inventowiz/Hail-Met/docs/poster/alberta-saferoads-helment-poster.jpg

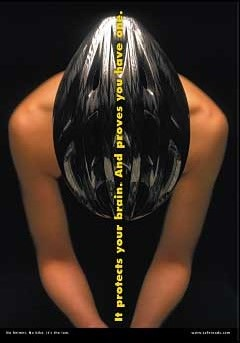
docs/poster/alberta-saferoads-helment-poster.jpg
