inventowiz/Hail-Met/docs/poster/DSC_0001.JPG

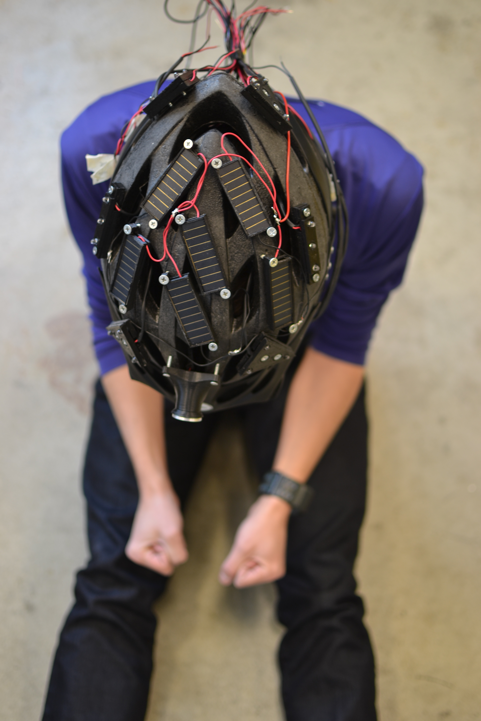
docs/poster/DSC_0001.JPG
