inventowiz/Hail-Met/README.md

Hail-Met
========

A repo for work done on the Hail-met project for EECS 473, Fall 2014.
