inventowiz/Hail-Met/docs/poster/poster final USE THIS ONE.pdf

### EECS 473 Advanced Embedded Systems: Fall 2014

Brian Daniels, Patrick Hayes, Alex Jaeckel, Brian Margosian, and Ben Wang {bridadan, pathayes, ajaeckel, bmargosi, benwang} @umich.edu https://github.com/inventowiz/Hail-Met
© 2013 Regents of The University of Michigan

# An all-in-one multi-purpose helmet

for the modern commuter.

# Hail-Met!

# Intro

# Problem

# Solution

# Interfacing & Software Design

# Prototyping, Testing, & Issues

# Hardware

Custom PCB

PCB with Bluetooth, LiPo Battery, Charging, and LED Driver
Turn Signals, Headlight and Taillight

Speakers

Solar panels

Heads up display (HUD)

The Hail-met runs on an
ATMega328 processor that
we developed on using the
Arduino IDE. We developed
our own libraries for each component so that we could more easily write software to interface with them. The software is responsible for monitoring each button and sensor input, and activating each respective component in response.

Besides protecting your head from direct contact with hard surfaces, traditional bike helmets don’t offer many benefits to consumers. Advanced communication, entertainment, and night-time safety features come standard with every new car, but don’t yet exist for cyclists.

Advanced communication,
entertainment, and night-time safety features come standard with every new car, but don’t yet exist for cyclists.

More modular solutions (like stand-alone detachable bike head lights) do exist but are easily stolen if they are not detached when the bike is in public.

Bicycle helmets are exposed to the elements (moisture, dust, etc.), so embedding electronic devices into a helmet is no easy feat.

Our group designed a smart bike helmet. It extends the functionality of traditional bike helmets by adding safety and productivity features like headlights and taillights, turn signals and Bluetooth communication.

Users will be able to stream music to their helmet while they commute as well as answer incoming phone calls, all over Bluetooth. Rider visibility will be increased due to the remarkably bright LED headlight and the LED turn signals. To top it all off, the helmet will be completely powered by solar panels and a small battery. The user can charge the helmet’s battery through any standard USB port, and the solar panels will also charge the battery during your ride!

Circuit Progress

Initial circuit on a breadboard | First view of the unpopulated PCBs

Populated, tested, and running PCB

Milled and cleaned 3-D printed part

First mockup of the Hail-met layout Continuing to add parts to the final prototype

Helmet Process

Microcontroller
(ATmega328)

Photovoltaic
Cells

Charging
circuit | Bluetooth
| module
| (RN-52)

Audio
Amplifier
(LM4880)

Headset
Microphone

LED Driver
(TLC5917IN)

Left turn signals -
front

Left turn signals -
middle

Right turn
signals - front

Right turn
signals - middle

Right turn
signals - rear

Left turn signals -
rear

Rear headlight /
Brake light

Primary
Power Switch

Turn signal
sensors (x2)

User input
buttons (x3)

Front headlight

UART | Analog `

Low-batt
(digital)

3.3V Voltage
Regulator

Li-ion
batteries

Digital

Headset
Speaker
(Left)

Headset
Speaker
(Right)

Digital (x3)

Digital (x2)

Analog input

LED Driver
(TLC5917IN)

SPI (2x Digital)

Turn indicator
LED (left)

Turn indicator
LED (right)

Low-battery
indicator LED

SPI (2x Digital)

Digital

Analog

Digital (x2)

Analog
