inventowiz/Hail-Met/schematics/thermistor_resistor_calculator.xlsx

Sheet: Thermistor Resistors
Thermistor Resistance Calculator
This spreadsheet calculates the resistance of a thermistor given parameters fom the specificaion.
Developed by Ben Wang, 11/20/14, University of Michigan
Datasheet: | http://www.vishay.com/docs/29049/ntcle100.pdf
 | R_25C | R_cold | R_hot
Temperature (°C): | 25 | 0 | 41
Temperature (°C): | 297.15 | 272.15 | 313.15
Resistance (Ω): | 10449.13 | 34260.06 | 5329.97
Parameter: | Number | B_25/85 (K) | A | B(K) | C(K^2) | D(K^3) | R_25C
Value: | 9 | 3977 | -14.6337 | 4791.842 | -115334 | -3730535 | 10000
 | A | B | C
Quadratic coefficients: | 9930.09 | -752210714.6 | -3.469499398e+12
 | Solution 1 | Solution 2
R_T2: | 80111.9421 | -4361.30378 |  | <-- Final Values
R_T1: | 2.516980831 | 28997.48302
 |  |  | Solution 1 | Solution 2
Check: | 24000 | = | 24000 | 24000
 | 5000 | = | 5000 | 5000

Sheet: PROG1 - Charge Current
PROG1 - Charging Current
I_reg = 1000V / R_PROG1
where | R_PROG | kOhms
 | I_reg | mA
Battery Capacity: | 2500 | mAh
Charging C-rate: | 0.2 | C
Desired I_reg: | 500 | mA
R_PROG: | 2 | kOhms

Sheet: PROG3 - Charge termination
PROG3 - Charging Current selection resistor
I_termination = 1000V / R_PROG3
where | R_PROG | kOhms
 | I_REG | mA
Battery Capacity: | 2500 | mAh
Cutoff rate: | 0.05 | C
Desired I_term: | 125 | mA
R_PROG3: | 8 | kOhms

Sheet: VPCC
VPCC - Voltage Proportional Charge Control - Voltage divider
R1 | 270 | kOhm | (Top)
R2 | 100 | kOhm | (Bottom)
V_in | 4.551
R_eq | 0.2702702703 | kOhm
VPCC | 1.23 | V
