inventowiz/Hail-Met/docs/poster/DSC_0002.JPG

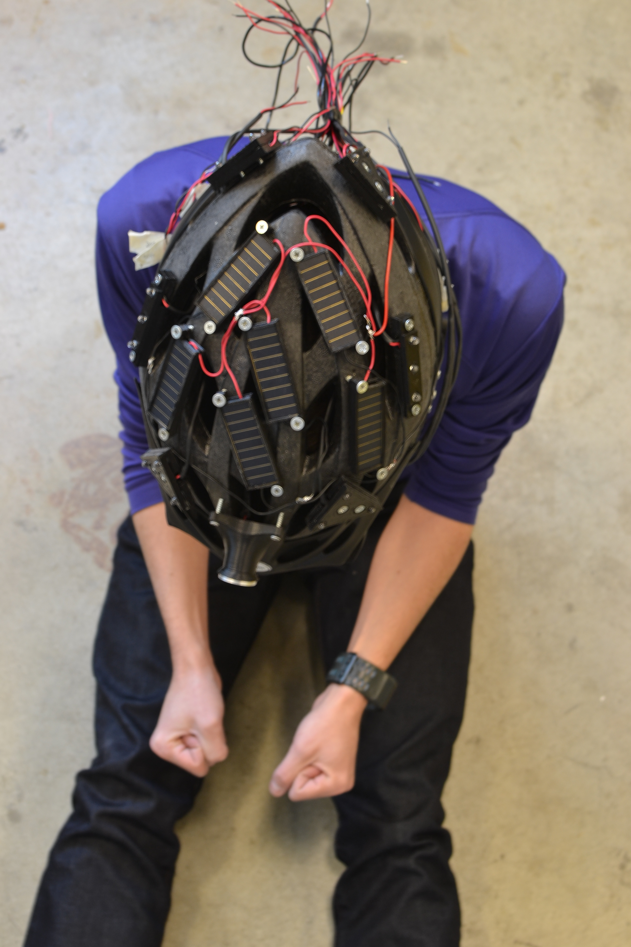
docs/poster/DSC_0002.JPG
