inventowiz/Hail-Met/docs/poster/DSC_0003.JPG

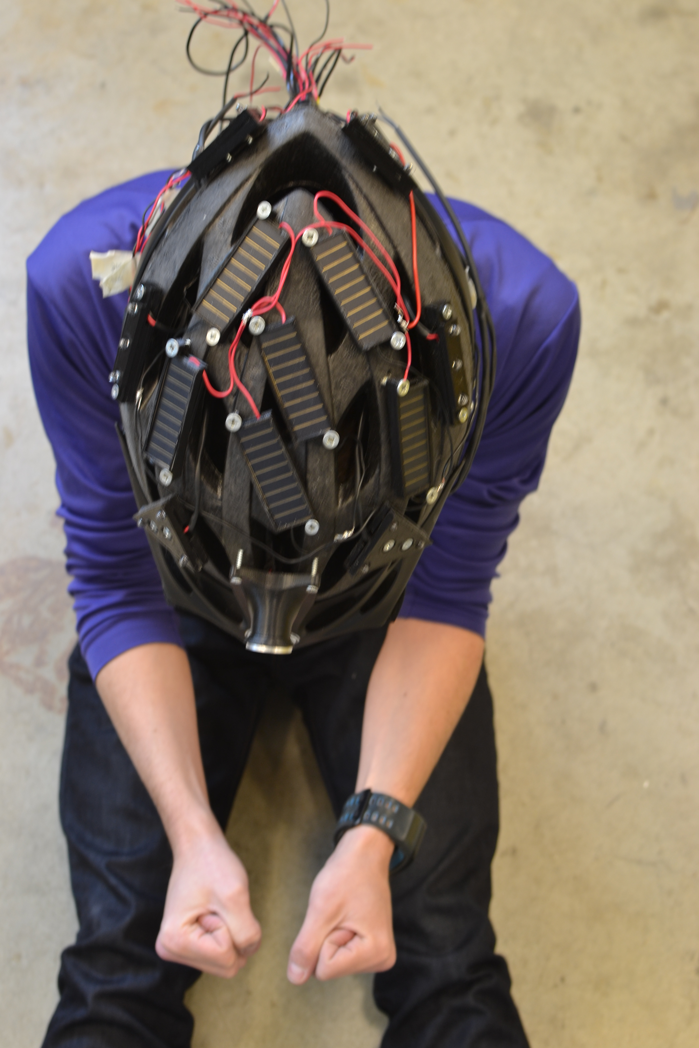
docs/poster/DSC_0003.JPG
