inventowiz/Hail-Met/docs/poster/helmet prototype 2.jpg

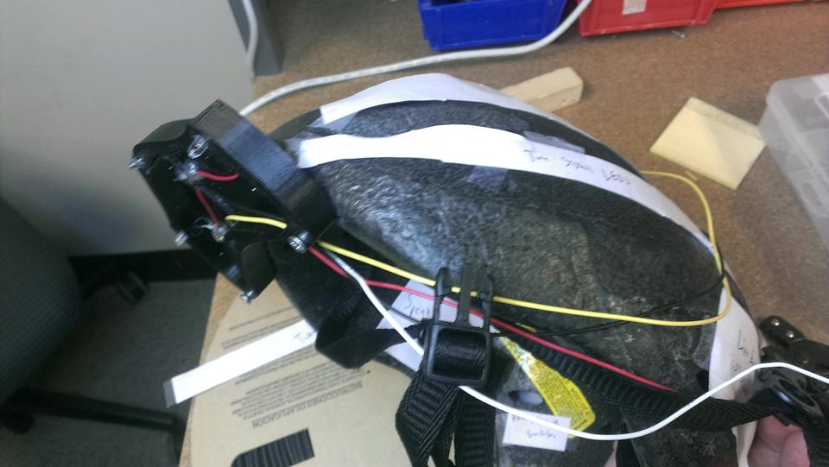
docs/poster/helmet prototype 2.jpg
