inventowiz/Hail-Met/docs/poster/helmet prototype.jpg

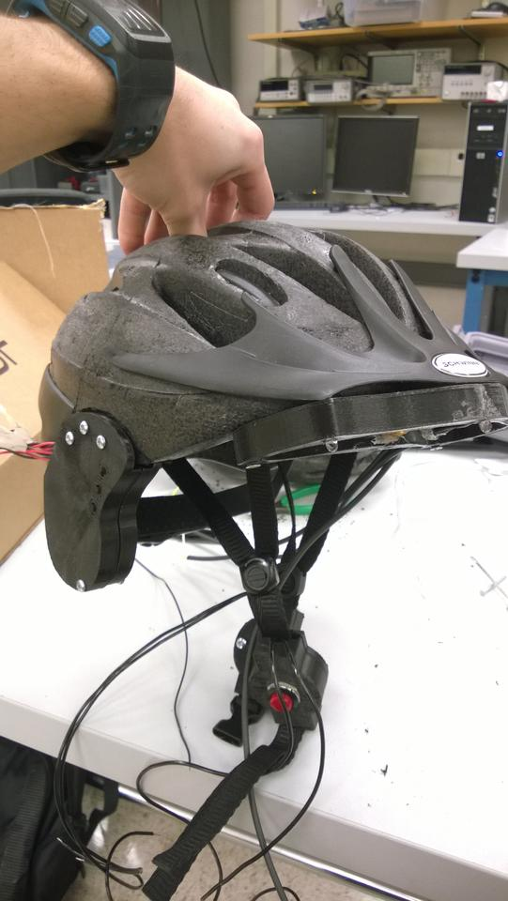
docs/poster/helmet prototype.jpg
