inventowiz/Hail-Met/docs/poster/Mill example.jpg

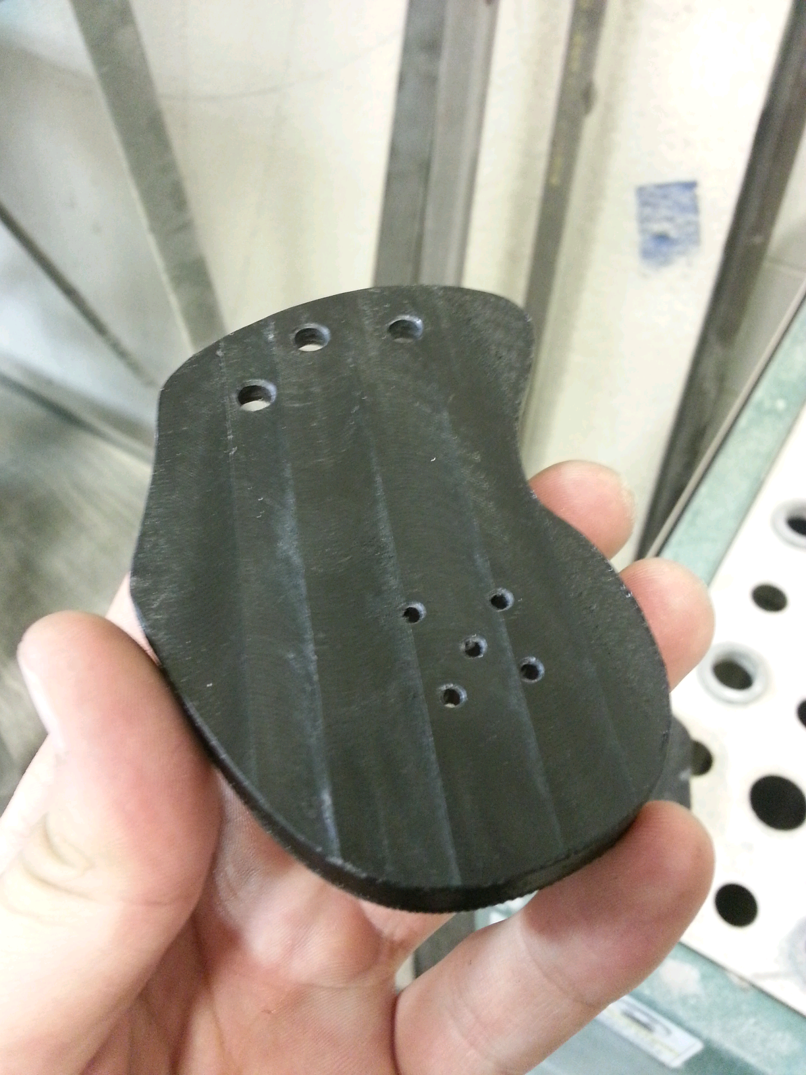
docs/poster/Mill example.jpg
