inventowiz/Hail-Met/schematics/BlockM-rball.bmp

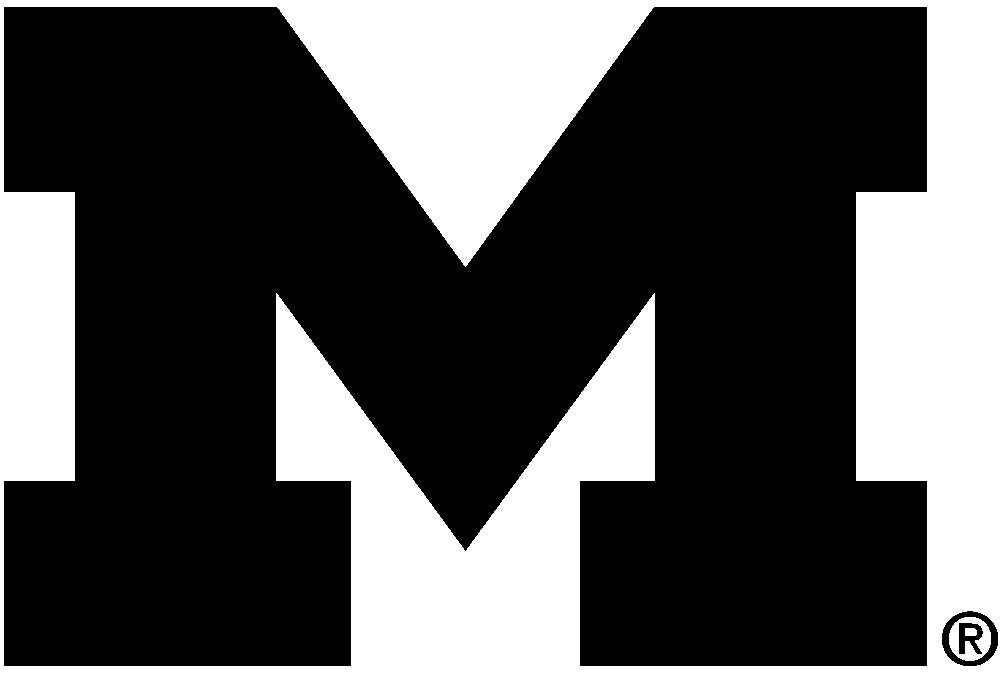
schematics/BlockM-rball.bmp
