inventowiz/Hail-Met/3dModels/chinModules/chinStrapModulev2.stl

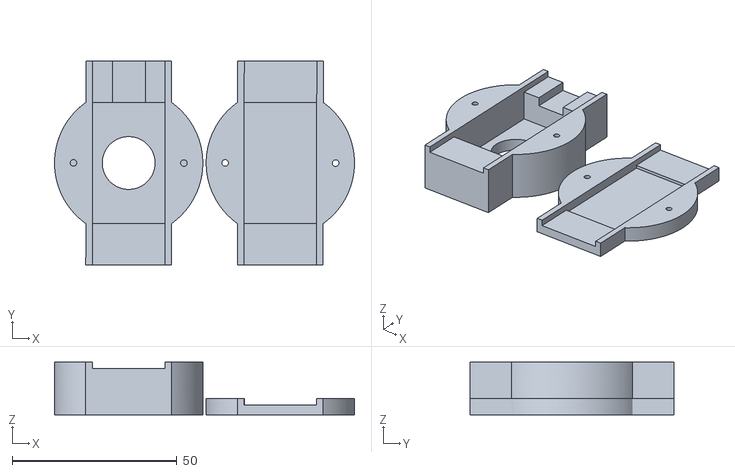
[picture p9: CAD file, 2014-11-24]
3dModels/chinModules/chinStrapModulev2.stl
91.0 x 62.0 x 16.0
