inventowiz/Hail-Met/3dModels/headlamp/headlamp_enclosure_cubify.stl

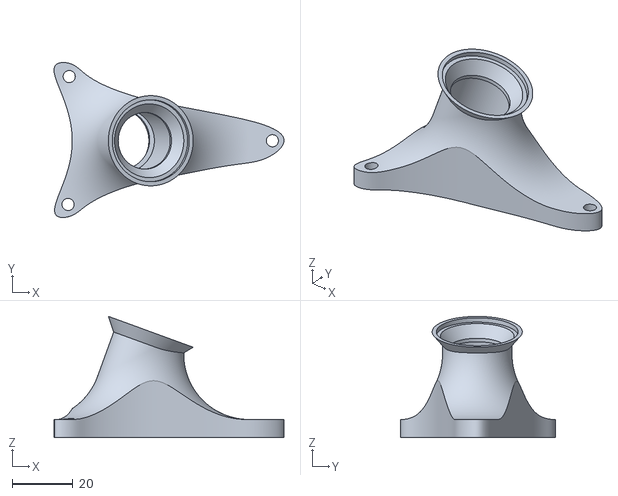
[picture p11: CAD file, 2014-10-27]
3dModels/headlamp/headlamp_enclosure_cubify.stl
75.9 x 51.1 x 40.0
