inventowiz/Hail-Met/3dModels/helmetBrim/helmetBrimRight.stl

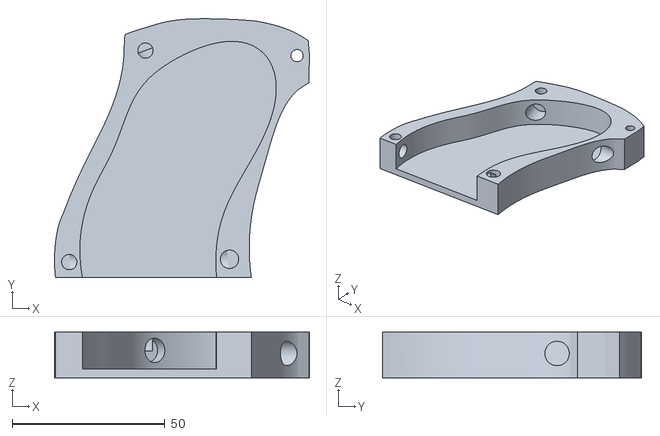
[picture p12: CAD file, 2014-11-17]
3dModels/helmetBrim/helmetBrimRight.stl
83.4 x 84.5 x 15.0
