inventowiz/Hail-Met/3dModels/lightSensorEnclosure/lightSensorEnclosure_cubify.stl

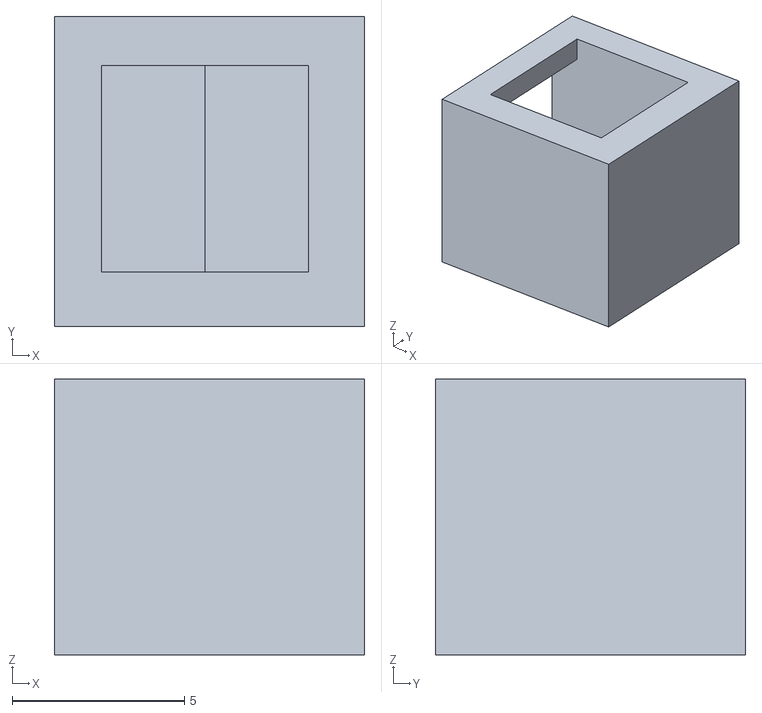
[picture p13: CAD file, 2014-12-03]
3dModels/lightSensorEnclosure/lightSensorEnclosure_cubify.stl
9.00 x 9.00 x 8.00
