inventowiz/Hail-Met/3dModels/pcbEnclosure/pcbEnclosureBatterySlot_cubify.stl

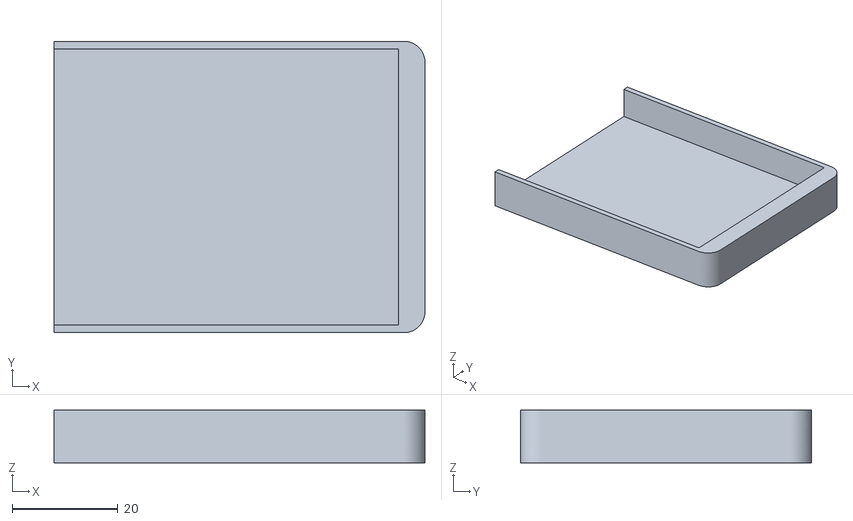
[picture p14: CAD file, 2014-12-03]
3dModels/pcbEnclosure/pcbEnclosureBatterySlot_cubify.stl
70.0 x 55.0 x 10.0
