inventowiz/Hail-Met/3dModels/powerSwitch/powerSwitch.stl

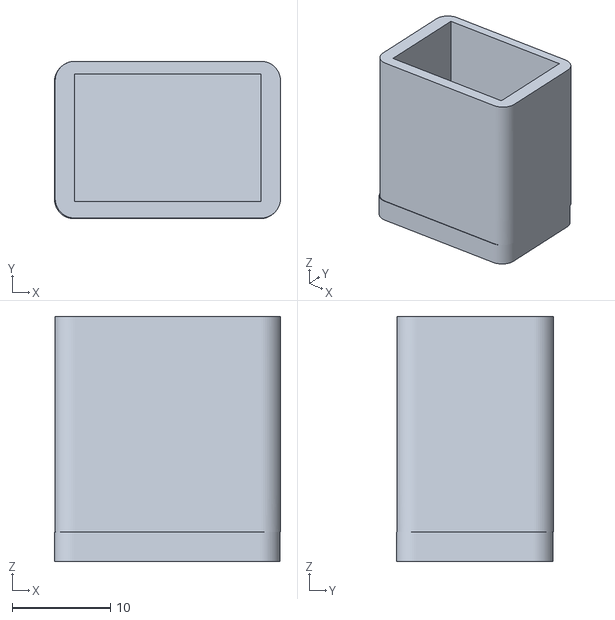
[picture p15: CAD file, 2014-12-03]
3dModels/powerSwitch/powerSwitch.stl
23.1 x 16.1 x 25.0
