inventowiz/Hail-Met/3dModels/solarPanelHousings/solarHousingGroup_cubify.stl

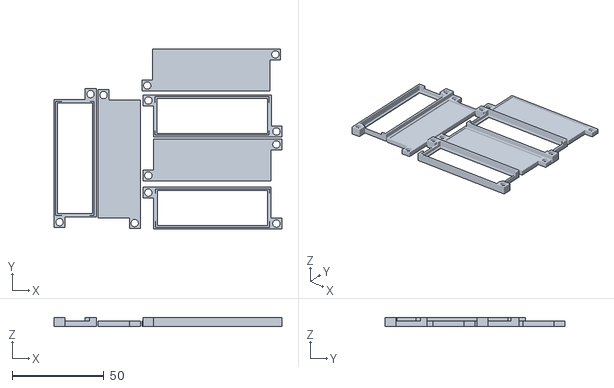
[picture p16: CAD file, 2014-12-03]
3dModels/solarPanelHousings/solarHousingGroup_cubify.stl
124.1 x 98.2 x 5.00
