inventowiz/Hail-Met/3dModels/tailLight/tailLight_cubify.stl

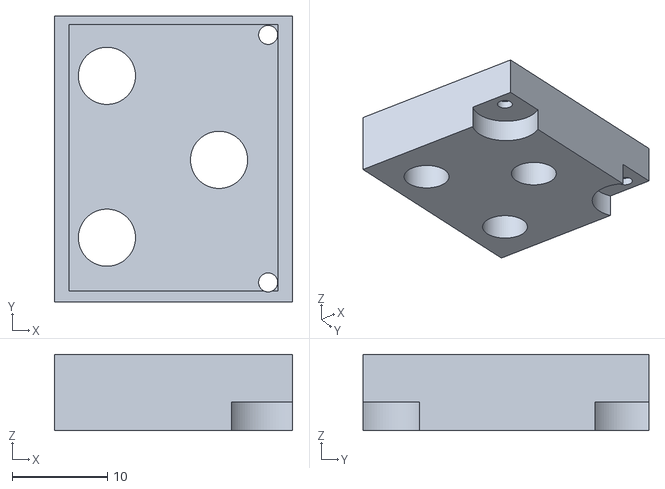
[picture p17: CAD file, 2014-12-03]
3dModels/tailLight/tailLight_cubify.stl
25.0 x 30.0 x 8.00
