inventowiz/Hail-Met/3dModels/turnSignalHousings/turnSignalsFront.stl

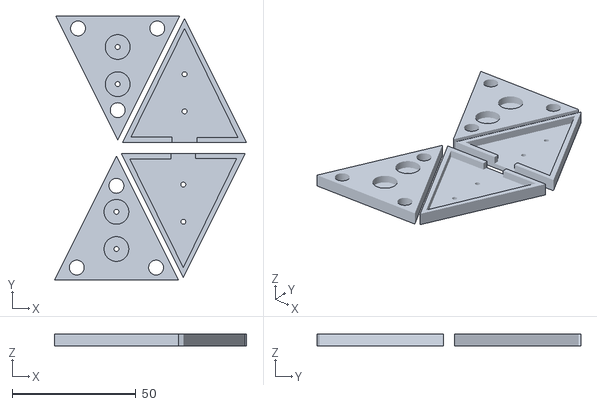
[picture p18: CAD file, 2014-11-27]
3dModels/turnSignalHousings/turnSignalsFront.stl
77.5 x 106.5 x 5.00
