inventowiz/Hail-Met/3dModels/earPieces/rightEarBottom_cubify.stl

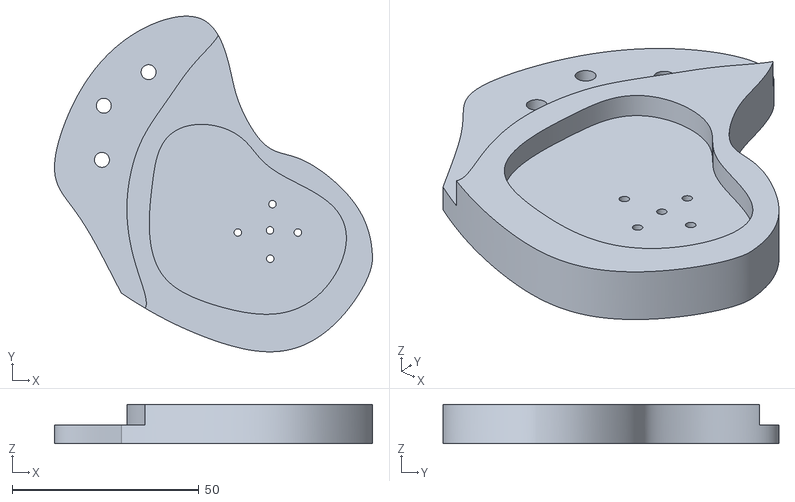
[picture p19: CAD file, 2014-10-30]
3dModels/earPieces/rightEarBottom_cubify.stl
85.2 x 89.9 x 10.5
