inventowiz/Hail-Met/3dModels/chinModules/chinStrapModule_cubify.stl

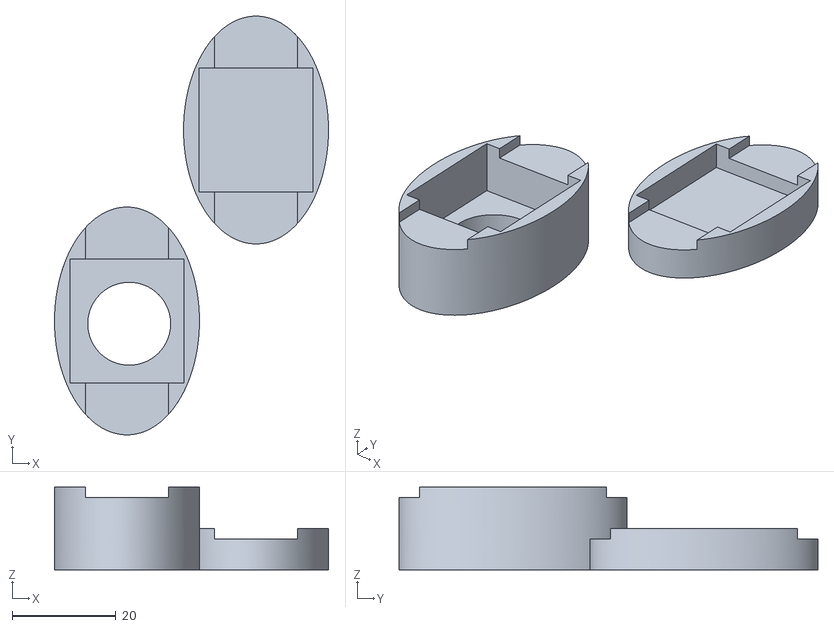
[picture p20: CAD file, 2014-11-17]
3dModels/chinModules/chinStrapModule_cubify.stl
52.9 x 80.9 x 16.0
