inventowiz/Hail-Met/3dModels/earPieces/rightEarTop.stl

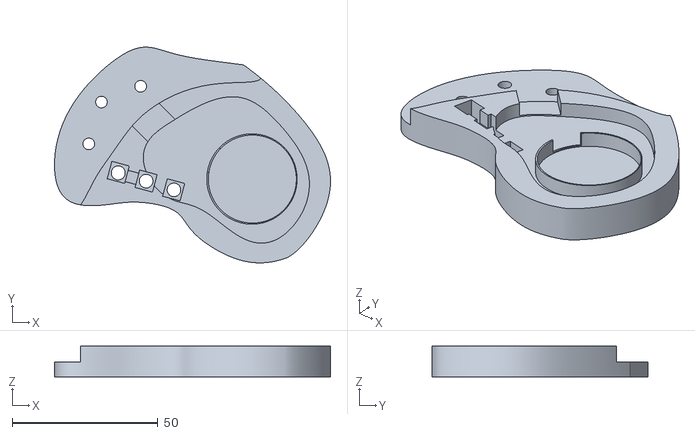
[picture p21: CAD file, 2014-10-30]
3dModels/earPieces/rightEarTop.stl
94.7 x 74.1 x 10.5
