inventowiz/Hail-Met/3dModels/helmetBrim/helmetBrimLeft.stl

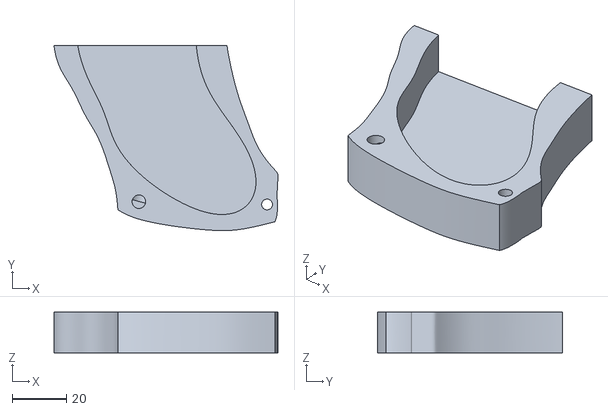
[picture p22: CAD file, 2014-11-17]
3dModels/helmetBrim/helmetBrimLeft.stl
82.9 x 68.6 x 15.0
