inventowiz/Hail-Met/3dModels/pcbEnclosure/pcbEnclosure.stl

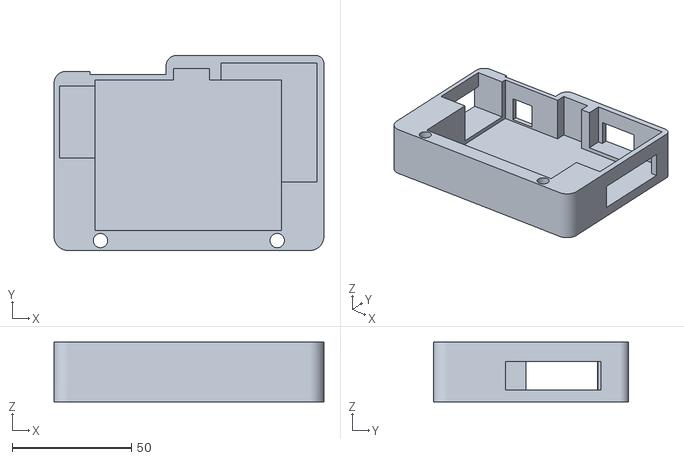
[picture p23: CAD file, 2014-11-27]
3dModels/pcbEnclosure/pcbEnclosure.stl
113.0 x 81.7 x 25.0
