inventowiz/Hail-Met/3dModels/turnSignalHousings/turnSignalsRight_cubify.stl

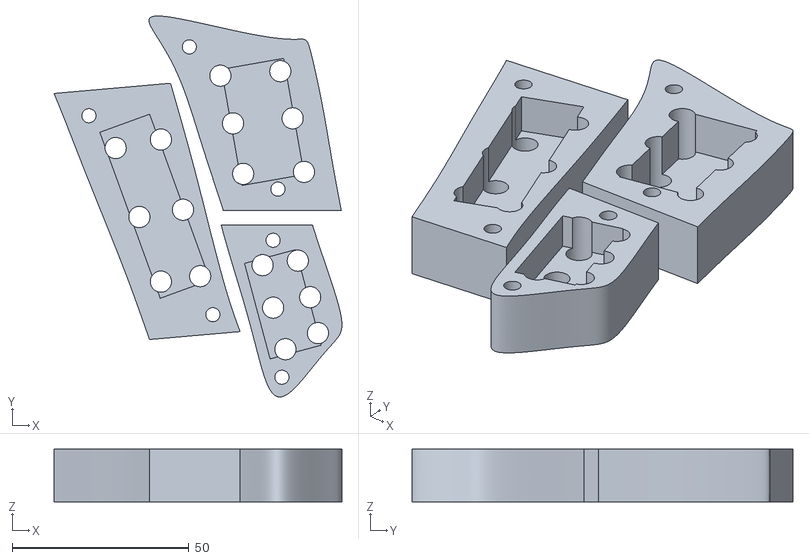
[picture p24: CAD file, 2014-11-17]
3dModels/turnSignalHousings/turnSignalsRight_cubify.stl
81.5 x 107.9 x 15.0
