inventowiz/Hail-Met/3dModels/earPieces/leftEarBottom.stl

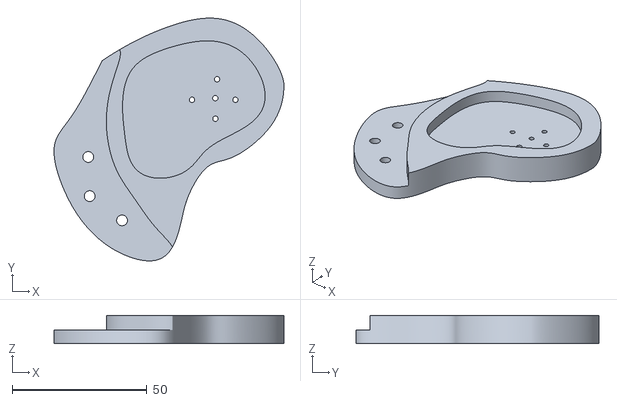
[picture p25: CAD file, 2014-10-27]
3dModels/earPieces/leftEarBottom.stl
85.2 x 89.9 x 10.5
