inventowiz/Hail-Met/3dModels/solarPanelHousings/solarHOusingV1.stl

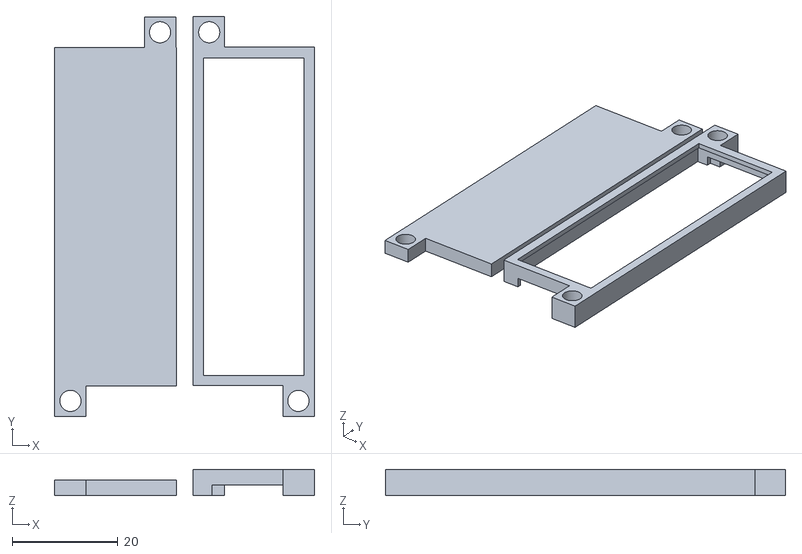
[picture p26: CAD file, 2014-11-24]
3dModels/solarPanelHousings/solarHOusingV1.stl
49.2 x 75.7 x 5.00
