inventowiz/Hail-Met/3dModels/turnSignalHousings/turnSignalsLeft_cubify.stl

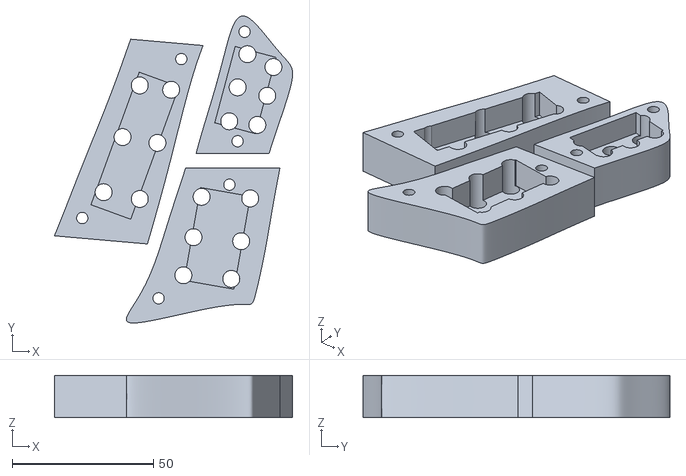
[picture p27: CAD file, 2014-11-17]
3dModels/turnSignalHousings/turnSignalsLeft_cubify.stl
84.4 x 108.8 x 15.0
