inventowiz/Hail-Met/3dModels/helmetBrim/helmetBrimLid_cubify_v.stl

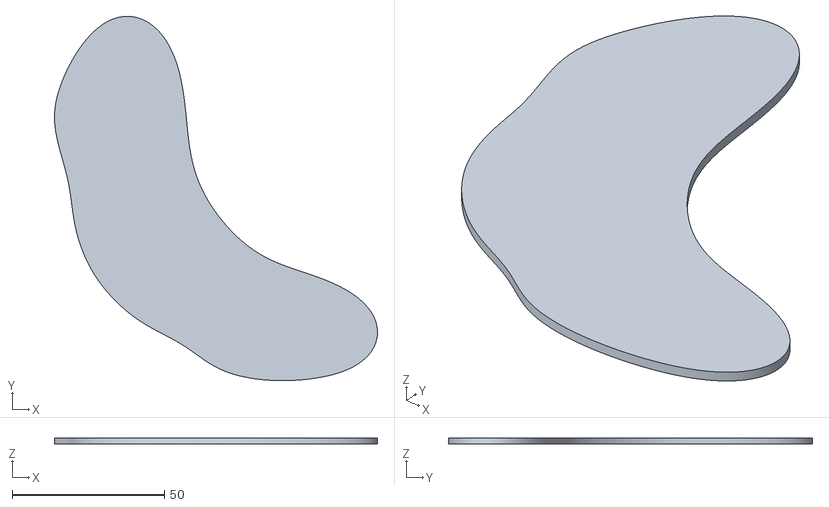
[picture p28: CAD file, 2014-11-04]
3dModels/helmetBrim/helmetBrimLid_cubify_v.stl
106.2 x 119.8 x 2.00
