inventowiz/Hail-Met/3dModels/helmetBrim/helmetBrimLid_cubify.stl

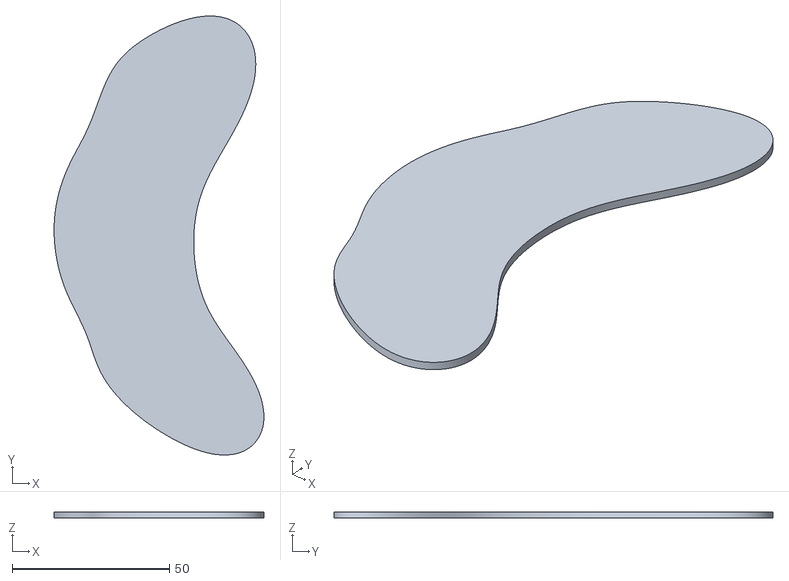
[picture p29: CAD file, 2014-11-04]
3dModels/helmetBrim/helmetBrimLid_cubify.stl
66.8 x 139.7 x 2.00
