inventowiz/Hail-Met/3dModels/solarPanelHousings/solarHOusingV1_cubify_v.stl

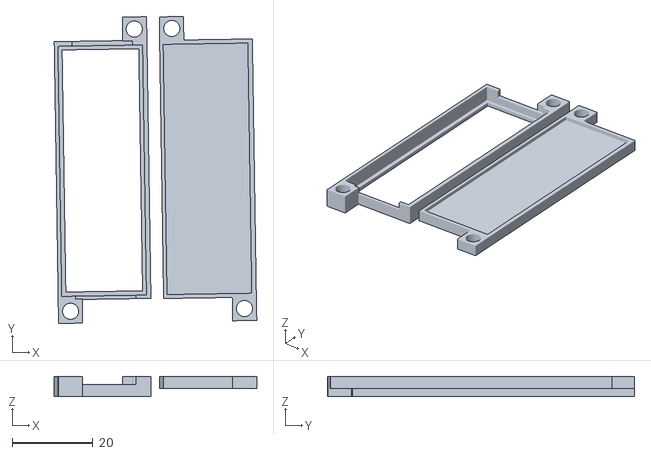
[picture p30: CAD file, 2014-11-24]
3dModels/solarPanelHousings/solarHOusingV1_cubify_v.stl
50.2 x 76.1 x 5.00
