inventowiz/Hail-Met/3dModels/helmetBrim/helmetBrim.stl

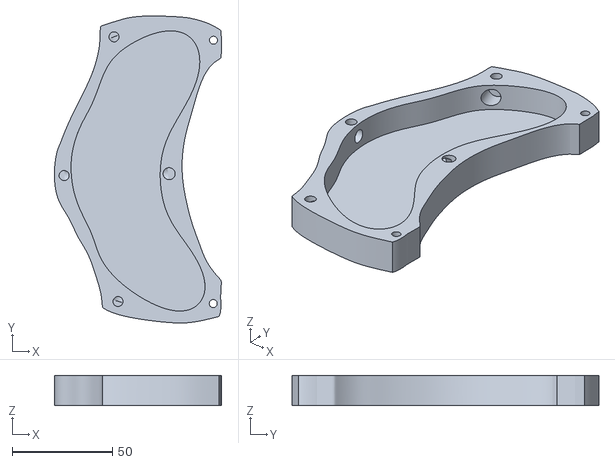
[picture p31: CAD file, 2014-11-04]
3dModels/helmetBrim/helmetBrim.stl
83.4 x 153.1 x 15.0
