inventowiz/Hail-Met/(list of files, cad)

Other CAD files:
3dModels/chinModules/chinStrapModulev2_cubify.stl
3dModels/helmetBrim/helmetBrimRight_cubify.stl
3dModels/lightSensorEnclosure/lightSensorEnclosure.stl
3dModels/pcbEnclosure/pcbEnclosureBatterySlot.stl
3dModels/powerSwitch/powerSwitch_cubify.stl
3dModels/solarPanelHousings/solarHousingGroup_cubify_v.stl
3dModels/tailLight/tailLight_cubify_v.stl
3dModels/turnSignalHousings/turnSignalsFront_cubify.stl
3dModels/solarPanelHousings/solarHousingGroup.stl
3dModels/tailLight/tailLight.stl
3dModels/chinModules/chinStrapModule.stl
3dModels/helmetBrim/helmetBrimLeft_cubify.stl
3dModels/pcbEnclosure/pcbEnclosure_cubify.stl
3dModels/earPieces/leftEarTop.stl
3dModels/solarPanelHousings/solarHOusingV1_cubify.stl
3dModels/earPieces/leftEarTop_cubify.stl
3dModels/earPieces/leftEarBottom_cubify.stl
3dModels/earPieces/rightEarBottom.stl
3dModels/helmetBrim/helmetBrimLid.stl
schematics/hail-met-v0/hail-met_hail-met-v0_0_standard.dxf
