inventowiz/Hail-Met/docs/poster/Board soldered.jpg

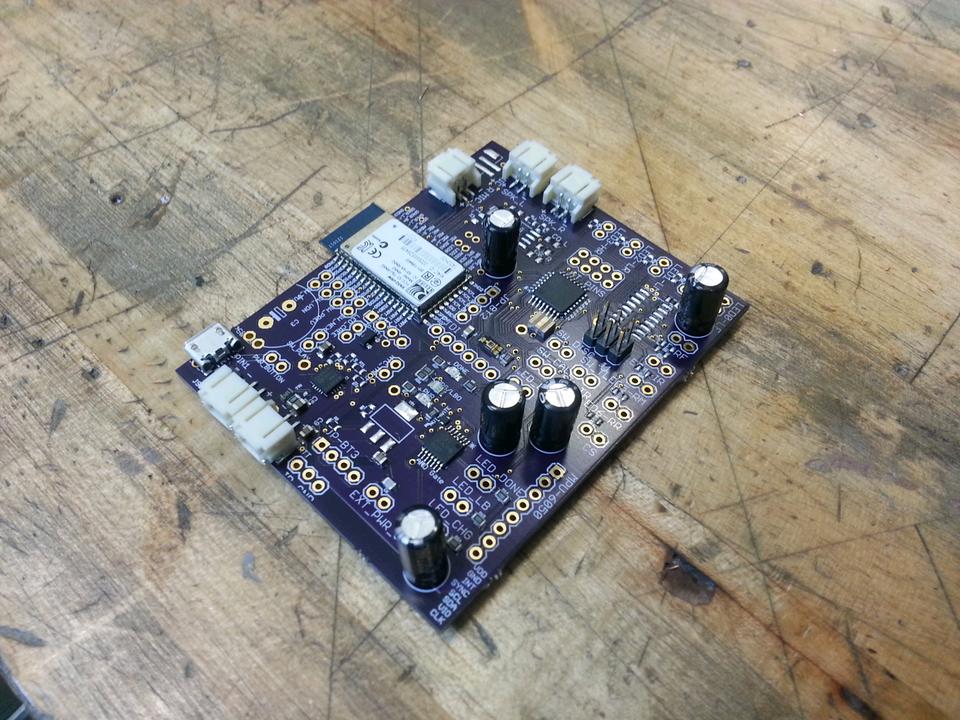
docs/poster/Board soldered.jpg
