inventowiz/Hail-Met/docs/poster/Board unsoldered.jpg

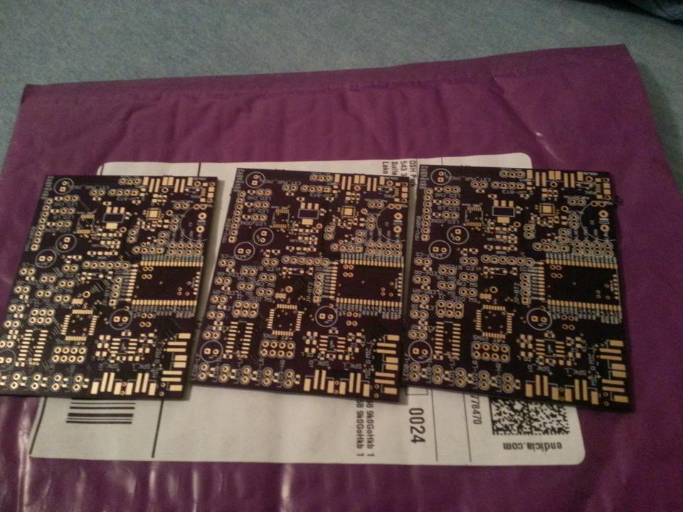
docs/poster/Board unsoldered.jpg
