inventowiz/Hail-Met/schematics/hail-met-v0/hail-met-v0.pdf

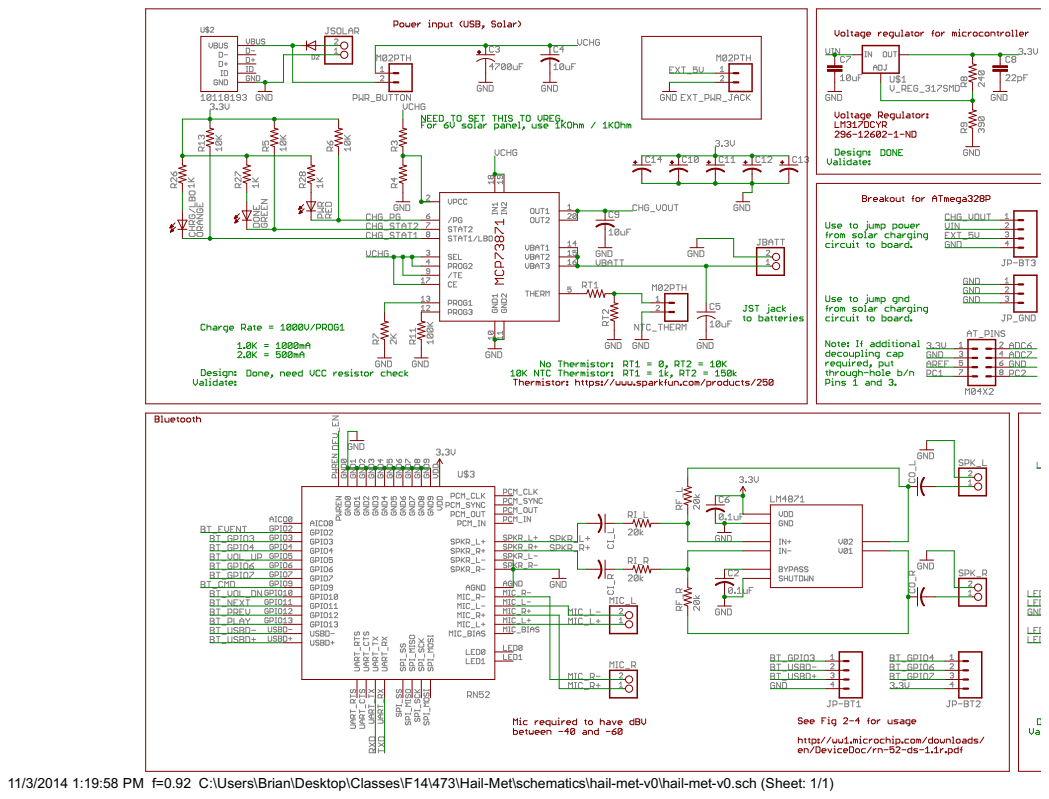
[picture p34: page 1]

11/3/2014 1:19:58 PM f=0.92 C:\Users\Brian\Desktop\Classes\F14\473\Hail-Met\schematics\hail-met-v0\hail-met-v0.sch (Sheet: 1/1)

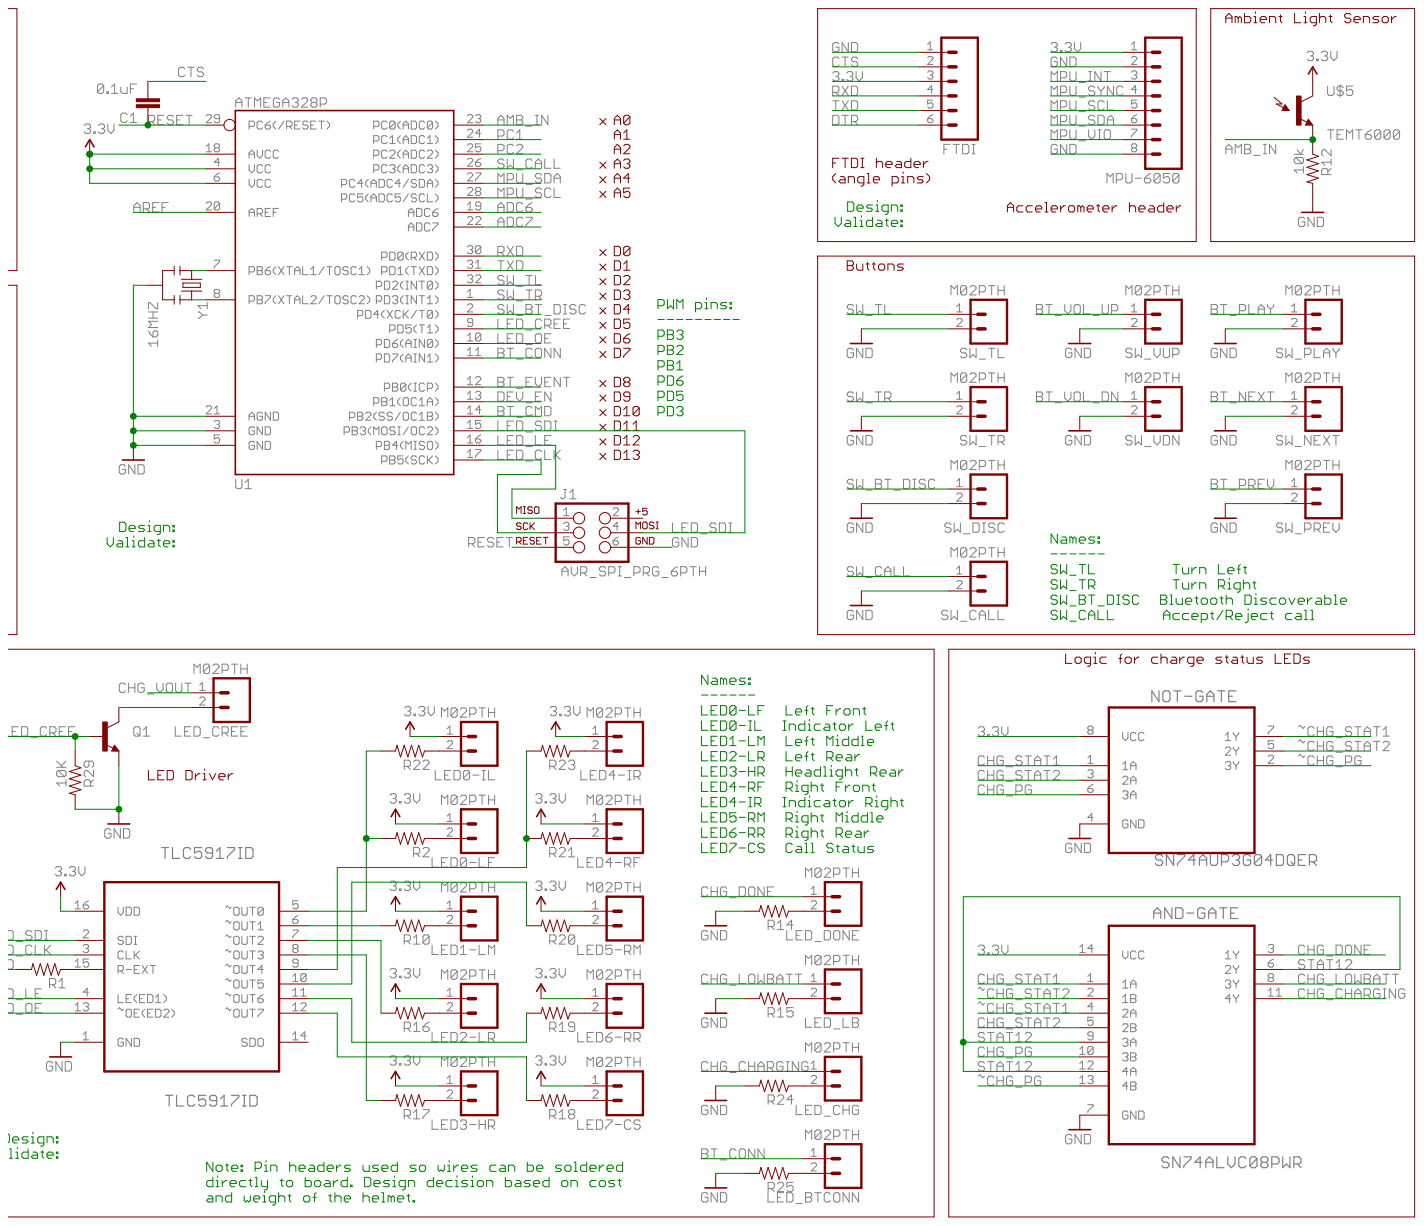
[picture p35: page 2]
