inventowiz/Hail-Met/schematics/hail-met-v0/hail-met-v0.brd

## EAGLE design schematics/hail-met-v0/hail-met-v0.brd (2014-12-01, an earlier design)

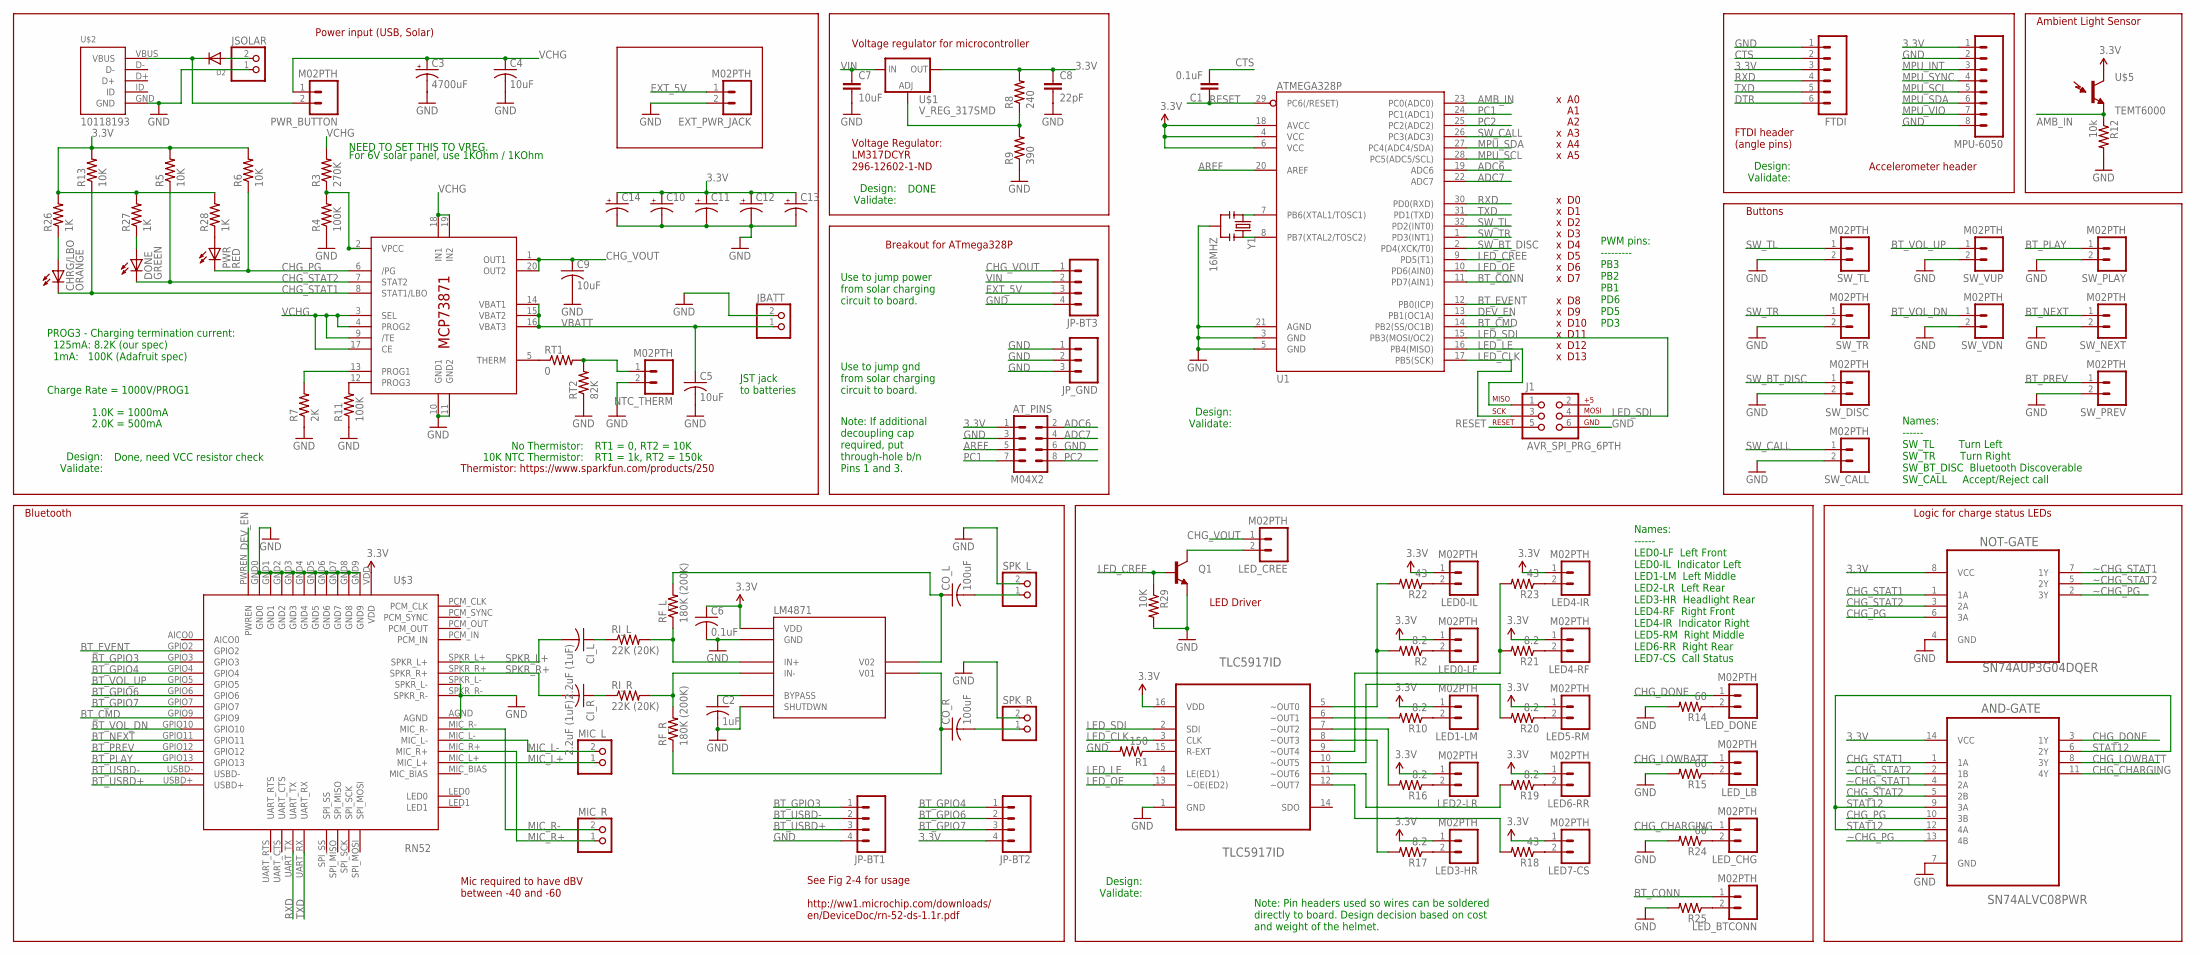
[picture p36: schematic hail-met-v0.sch]

Parts:
AND-GATE: SN74ALVC08PWR; SOP65P640X120-14N
AT_PINS: M04X2; 2X4
C1: 0.1uF; 0805
C2: 1uF; C0805K
C3: 4700uF; E5-13
C4, C5, C9: 10uF; C0805K
C6: 0.1uF; C0805K
C7: 10uF; 0805
C8: 22pF; 0805
C10, C11, C12, C13, C14: CAP_POLPTH1; CPOL-RADIAL-100UF-25V
CHRG/LBO: ORANGE; CHIP-LED0805
CI_L: 2.2uF (1uF); C0805K
CI_R: 2.2uF (1uF); C0805K
CO_L: 100uF; C0805K
CO_R: 100uF; C0805K
D2: DIODESOD-123; SOD-123
DONE: GREEN; CHIP-LED0805
EXT_PWR_JACK: M02PTH; 1X02
FTDI: M06LOCK; 1X06_LOCK
IC1: MCP73871; QFN20
J1: AVR_SPI_PRG_6PTH; 2X3
JBATT: JST_2PIN-SMT; JST-PH-2-SMT
JP-BT1, JP-BT2, JP-BT3: M04LOCK; 1X04_LOCK
JP_GND: M03LOCK; 1X03_LOCK
JSOLAR: JST_2PIN-SMT; JST-PH-2-SMT
LED0-IL, LED0-LF, LED1-LM, LED2-LR, LED3-HR, LED4-IR, LED4-RF, LED5-RM, LED6-RR, LED7-CS: M02PTH; 1X02
LED_BTCONN: M02PTH; 1X02
LED_CHG: M02PTH; 1X02
LED_CREE: M02PTH; 1X02
LED_DONE: M02PTH; 1X02
LED_LB: M02PTH; 1X02
LM4871: LM4871; SO08
MIC_L: JST_2PIN-SMT; JST-PH-2-SMT
MIC_R: JST_2PIN-SMT; JST-PH-2-SMT
MPU-6050: M08LOCK; 1X08_LOCK
NOT-GATE: SN74AUP3G04DQER; SON35P100X140X40-8N
NTC_THERM: M02PTH; 1X02
PWR: RED; CHIP-LED0805
PWR_BUTTON: M02PTH; 1X02
Q1: TRANSISTOR_NPNSOT23-3; SOT23-3
R1: 150; 0805
R2, R10, R16, R17, R19, R20, R21: 8.2; 0805
R3: 270K; 0805
R4, R11: 100K; 0805
R5, R6, R13, R29: 10K; 0805
R7: 2K; 0805
R8: 240; 0805
R9: 390; 0805
R12: 10k; 0805
R14, R15, R24: 60; 0805
R18, R22, R23: 43; 0805
R25: RESISTOR0805-RES; 0805
R26, R27, R28: 1K; 0805
RF_L: 180K (200K); 0805
RF_R: 180K (200K); 0805
RI_L: 22K (20K); 0805
RI_R: 22K (20K); 0805
RT1: 0; 0805
RT2: 82K; 0805
SPK_L: JST_2PIN-SMT; JST-PH-2-SMT
SPK_R: JST_2PIN-SMT; JST-PH-2-SMT
SW_CALL: M02PTH; 1X02
SW_DISC: M02PTH; 1X02
SW_NEXT: M02PTH; 1X02
SW_PLAY: M02PTH; 1X02
SW_PREV: M02PTH; 1X02
SW_TL: M02PTH; 1X02
SW_TR: M02PTH; 1X02
SW_VDN: M02PTH; 1X02
SW_VUP: M02PTH; 1X02
TLC5917ID: TLC5917ID; SOIC127P600X175-16N
U1: ATMEGA328P; TQFP32-08
U$1: V_REG_317SMD; SOT223
U$2: 10118193
U$3: RN52
U$5: TEMT6000; TEMT6000-SEN
Y1: 16MHZ; RESONATOR-SMD

Connections:
3.3V: AND-GATE.14 (VCC), AT_PINS.1, C6.1, C8.1, C10.1 (+), C11.1 (+), C12.1 (+), C13.1 (+), C14.1 (+), FTDI.3, JP-BT2.4, LED0-IL.1, LED0-LF.1, LED1-LM.1, LED2-LR.1, LED3-HR.1, LED4-IR.1, LED4-RF.1, LED5-RM.1, LED6-RR.1, LED7-CS.1, LM4871.6 (VDD), MPU-6050.1, NOT-GATE.8 (VCC), R5.2, R6.2, R8.2, R13.2, R26.2, R27.2, R28.2, TLC5917ID.16 (VDD), U1.4 (VCC), U1.6 (VCC), U1.18 (AVCC), U$1.2 (OUT), U$3.VDD, U$5.COLLECTOR (C1)
ADC6: AT_PINS.2, U1.19 (ADC6)
ADC7: AT_PINS.4, U1.22 (ADC7)
AMB_IN: R12.1, U1.23 (PC0(ADC0)), U$5.EMITTER (E1)
AREF: AT_PINS.5, U1.20 (AREF)
BT_CMD: U1.14 (PB2(SS/OC1B)), U$3.GPIO9
BT_CONN: LED_BTCONN.1, U1.11 (PD7(AIN1))
BT_EVENT: U1.12 (PB0(ICP)), U$3.GPIO2
BT_GPIO3: JP-BT1.1, U$3.GPIO3
BT_GPIO4: JP-BT2.1, U$3.GPIO4
BT_GPIO6: JP-BT2.2, U$3.GPIO6
BT_GPIO7: JP-BT2.3, U$3.GPIO7
BT_NEXT: SW_NEXT.1, U$3.GPIO11
BT_PLAY: SW_PLAY.1, U$3.GPIO13
BT_PREV: SW_PREV.1, U$3.GPIO12
BT_USBD+: JP-BT1.3, U$3.USBD+
BT_USBD-: JP-BT1.2, U$3.USBD-
BT_VOL_DN: SW_VDN.1, U$3.GPIO10
BT_VOL_UP: SW_VUP.1, U$3.GPIO5
CHG_CHARGING: AND-GATE.11 (4Y), LED_CHG.1
CHG_DONE: AND-GATE.3 (1Y), LED_DONE.1
CHG_LOWBATT: AND-GATE.8 (3Y), LED_LB.1
CHG_PG: AND-GATE.10 (3B), IC1.6 (/PG), NOT-GATE.6 (3A), PWR.C, R6.1
CHG_STAT1: AND-GATE.1 (1A), CHRG/LBO.C, IC1.8 (STAT1/LBO), NOT-GATE.1 (1A), R13.1
CHG_STAT2: AND-GATE.5 (2B), DONE.C, IC1.7 (STAT2), NOT-GATE.3 (2A), R5.1
CHG_VOUT: C9.1, IC1.1 (OUT1), IC1.20 (OUT2), JP-BT3.1, LED_CREE.1
CTS: C1.2, FTDI.2
DEV_EN: U1.13 (PB1(OC1A)), U$3.PWREN
DTR: FTDI.6
EXT_5V: EXT_PWR_JACK.1, JP-BT3.3
GND: AND-GATE.7 (GND), AT_PINS.3, AT_PINS.6, C2.2, C3.-, C4.2, C5.2, C6.2, C7.2, C8.2, C9.2, C10.2 (-), C11.2 (-), C12.2 (-), C13.2 (-), C14.2 (-), EXT_PWR_JACK.2, FTDI.1, IC1.10 (GND1), IC1.11 (GND2), J1.6, JBATT.2 (1), JP-BT1.4, JP-BT3.4, JP_GND.1, JP_GND.2, JP_GND.3, JSOLAR.1 (2), LM4871.1 (SHUTDWN), LM4871.7 (GND), MPU-6050.2, MPU-6050.8, NOT-GATE.4 (GND), NTC_THERM.2, Q1.2 (E), R1.2, R4.1, R7.1, R9.1, R11.1, R12.2, R14.2, R15.2, R24.2, R25.2, R29.2, RT2.1, SPK_L.2 (1), SPK_R.2 (1), SW_CALL.2, SW_DISC.2, SW_NEXT.2, SW_PLAY.2, SW_PREV.2, SW_TL.2, SW_TR.2, SW_VDN.2, SW_VUP.2, TLC5917ID.1 (GND), U1.3 (GND), U1.5 (GND), U1.21 (AGND), U$2.GND, U$3.AGND, U$3.GND0, U$3.GND1, U$3.GND2, U$3.GND3, U$3.GND4, U$3.GND5, U$3.GND6, U$3.GND7, U$3.GND8, U$3.GND9, U$3.SPKR_L-, U$3.SPKR_R-, Y1.2
LED_CLK: J1.3, TLC5917ID.3 (CLK), U1.17 (PB5(SCK))
LED_CREE: Q1.1 (B), R29.1, U1.9 (PD5(T1))
LED_LE: J1.1, TLC5917ID.4 (LE(ED1)), U1.16 (PB4(MISO))
LED_OE: TLC5917ID.13 (~OE(ED2)), U1.10 (PD6(AIN0))
LED_SDI: J1.4, TLC5917ID.2 (SDI), U1.15 (PB3(MOSI/OC2))
MIC_L+: MIC_L.1 (2), U$3.MIC_L+
MIC_L-: MIC_L.2 (1), U$3.MIC_L-
MIC_R+: MIC_R.1 (2), U$3.MIC_R+
MIC_R-: MIC_R.2 (1), U$3.MIC_R-
MPU_INT: MPU-6050.3
MPU_SCL: MPU-6050.5, U1.28 (PC5(ADC5/SCL))
MPU_SDA: MPU-6050.6, U1.27 (PC4(ADC4/SDA))
MPU_SYNC: MPU-6050.4
MPU_VIO: MPU-6050.7
unnamed: U1.7 (PB6(XTAL1/TOSC1)), Y1.1
unnamed: U1.8 (PB7(XTAL2/TOSC2)), Y1.3
unnamed: IC1.5 (THERM), RT1.1
unnamed: R8.1, R9.2, U$1.1 (ADJ)
unnamed: R2.2, R22.2, TLC5917ID.5 (~OUT0)
unnamed: R10.2, TLC5917ID.6 (~OUT1)
unnamed: R16.2, TLC5917ID.7 (~OUT2)
unnamed: R17.2, TLC5917ID.8 (~OUT3)
unnamed: R21.2, R23.2, TLC5917ID.9 (~OUT4)
unnamed: R20.2, TLC5917ID.10 (~OUT5)
unnamed: R19.2, TLC5917ID.11 (~OUT6)
unnamed: R18.2, TLC5917ID.12 (~OUT7)
unnamed: NTC_THERM.1, RT1.2, RT2.2
unnamed: CO_L.2, SPK_L.1 (2)
unnamed: D2.A, JSOLAR.2 (1)
unnamed: LED_BTCONN.2, R25.1
unnamed: IC1.2 (VPCC), R3.1, R4.2
unnamed: IC1.12 (PROG3), R11.2
unnamed: LED_CREE.2, Q1.3 (C)
unnamed: CHRG/LBO.A, R26.1
unnamed: DONE.A, R27.1
unnamed: LED_DONE.2, R14.1
unnamed: PWR.A, R28.1
unnamed: LED_LB.2, R15.1
unnamed: CO_R.2, SPK_R.1 (2)
unnamed: LED_CHG.2, R24.1
unnamed: R1.1, TLC5917ID.15 (R-EXT)
unnamed: LED0-LF.2, R2.1
unnamed: LED4-RF.2, R21.1
unnamed: LED5-RM.2, R20.1
unnamed: LED6-RR.2, R19.1
unnamed: LED7-CS.2, R18.1
unnamed: LED3-HR.2, R17.1
unnamed: LED1-LM.2, R10.1
unnamed: LED2-LR.2, R16.1
unnamed: LED0-IL.2, R22.1
unnamed: LED4-IR.2, R23.1
unnamed: LM4871.4 (IN-), RF_R.2, RI_R.2
unnamed: CI_L.1, RI_L.1
unnamed: C2.1, LM4871.2 (BYPASS)
unnamed: LM4871.3 (IN+), RF_L.1, RI_L.2
unnamed: CI_R.1, RI_R.1
unnamed: D2.C, PWR_BUTTON.2, U$2.VBUS
PC1: AT_PINS.7, U1.24 (PC1(ADC1))
PC2: AT_PINS.8, U1.25 (PC2(ADC2))
PROG1: IC1.13 (PROG1), R7.2
RESET: C1.1, J1.5, U1.29 (PC6(/RESET))
RXD: FTDI.4, U1.30 (PD0(RXD)), U$3.UART_TX
SPKR_L: CO_L.1, LM4871.8 (V02), RF_L.2
SPKR_L+: CI_L.2, U$3.SPKR_L+
SPKR_R: CO_R.1, LM4871.5 (V01), RF_R.1
SPKR_R+: CI_R.2, U$3.SPKR_R+
STAT12: AND-GATE.6 (2Y), AND-GATE.9 (3A), AND-GATE.12 (4A)
SW_BT_DISC: SW_DISC.1, U1.2 (PD4(XCK/T0))
SW_CALL: SW_CALL.1, U1.26 (PC3(ADC3))
SW_TL: SW_TL.1, U1.32 (PD2(INT0))
SW_TR: SW_TR.1, U1.1 (PD3(INT1))
TXD: FTDI.5, U1.31 (PD1(TXD)), U$3.UART_RX
VBATT: C5.1, IC1.14 (VBAT1), IC1.15 (VBAT2), IC1.16 (VBAT3), JBATT.1 (2)
VCHG: C3.+, C4.1, IC1.3 (SEL), IC1.4 (PROG2), IC1.9 (/TE), IC1.17 (CE), IC1.18 (IN1), IC1.19 (IN2), PWR_BUTTON.1, R3.2
VIN: C7.1, JP-BT3.2, U$1.3 (IN)
~CHG_PG: AND-GATE.13 (4B), NOT-GATE.2 (3Y)
~CHG_STAT1: AND-GATE.4 (2A), NOT-GATE.7 (1Y)
~CHG_STAT2: AND-GATE.2 (1B), NOT-GATE.5 (2Y)

Notes on the sheet:
PWM pins: --------- PB3 PB2 PB1 PD6 PD5 PD3
JST jack to batteries
Voltage regulator for microcontroller
LED Driver
Power input (USB, Solar)
No Thermistor:
10K NTC Thermistor:
RT1 = 0, RT2 = 10K
RT1 = 1k, RT2 = 150k
Charge Rate = 1000V/PROG1
1.0K = 1000mA
2.0K = 500mA
NEED TO SET THIS TO VREG. For 6V solar panel, use 1KOhm / 1KOhm
DONE
Design: Validate:
Done, need VCC resistor check
Bluetooth
Note: Pin headers used so wires can be soldered directly to board. Design decision based on cost and weight of the helmet.
Names: ------ LED0-LF Left Front LED0-IL Indicator Left LED1-LM Left Middle LED2-LR Left Rear LED3-HR Headlight Rear LED4-RF Right Front LED4-IR Indicator Right LED5-RM Right Middle LED6-RR Right Rear LED7-CS Call Status
Thermistor: https://www.sparkfun.com/products/250
Accelerometer header
FTDI header (angle pins)
Ambient Light Sensor
Buttons
Names: ------ SW_TL Turn Left SW_TR Turn Right SW_BT_DISC Bluetooth Discoverable SW_CALL Accept/Reject call
Voltage Regulator: LM317DCYR 296-12602-1-ND
Mic required to have dBV between -40 and -60
D10
D11
D12
See Fig 2-4 for usage http://ww1.microchip.com/downloads/ en/DeviceDoc/rn-52-ds-1.1r.pdf
D13
Logic for charge status LEDs
Breakout for ATmega328P
Note: If additional decoupling cap required, put through-hole b/n Pins 1 and 3.
Use to jump gnd from solar charging circuit to board.
Use to jump power from solar charging circuit to board.
PROG3 - Charging termination current: 125mA: 8.2K (our spec) 1mA: 100K (Adafruit spec)

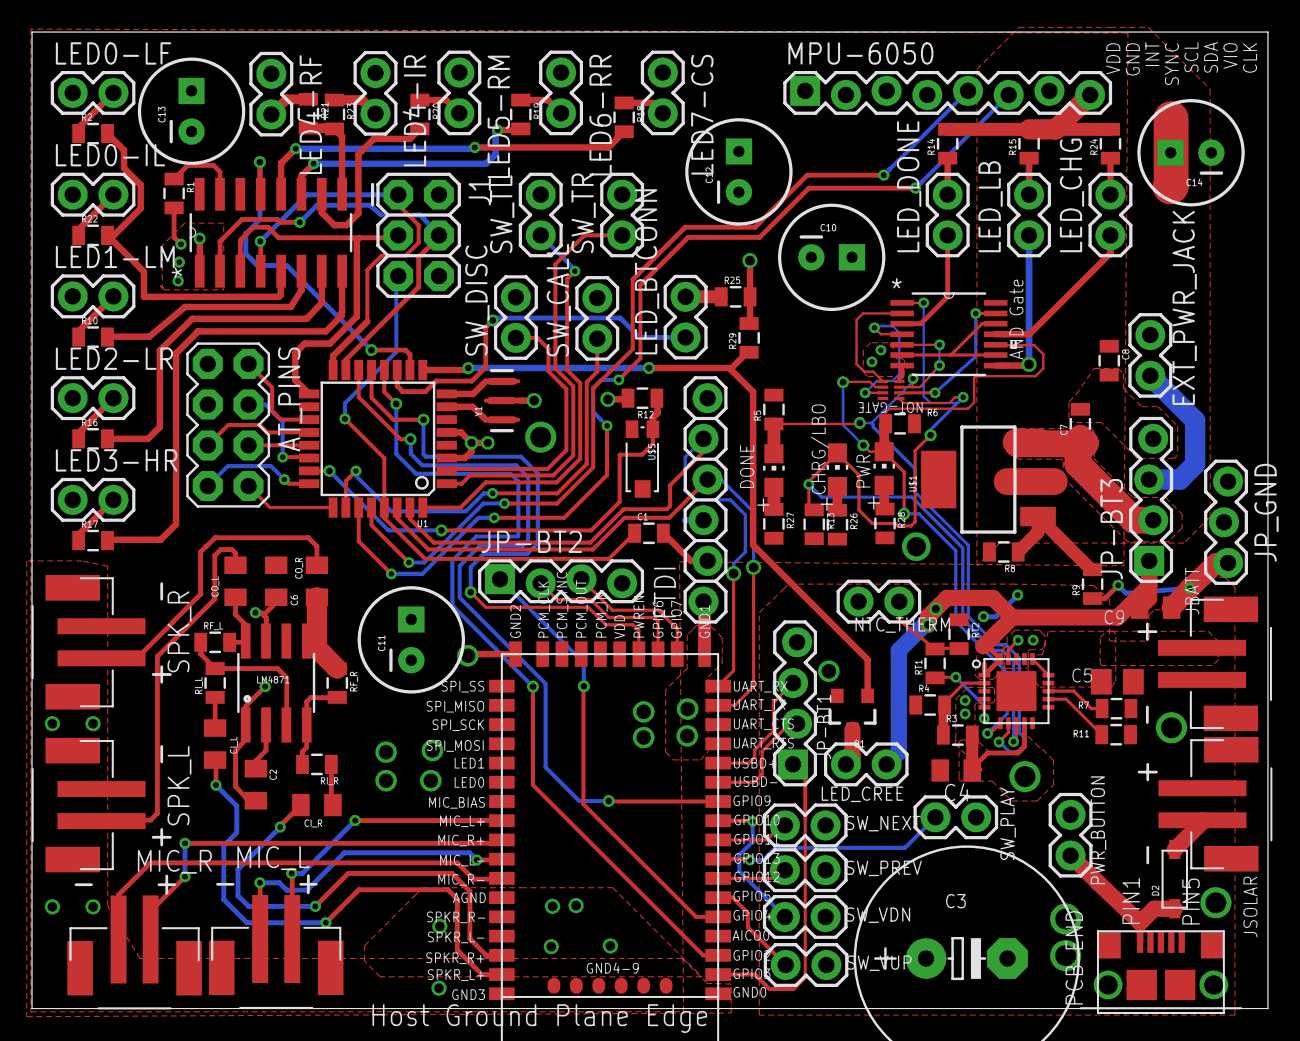
[picture p37: board hail-met-v0.brd from above]

Board: 2 copper layers, 77.1 x 61.0 mm, 110 parts (0 on the bottom side), 105 nets.
