inventowiz/Hail-Met/schematics/reference_designs/USB-DC-Solar-Lithium-Ion-Polymer-charger/Adafruit MCP73871 Solar Charger v4.brd

## EAGLE design schematics/reference_designs/USB-DC-Solar-Lithium-Ion-Polymer-charger/Adafruit MCP73871 Solar Charger v4.brd (2014-10-10)

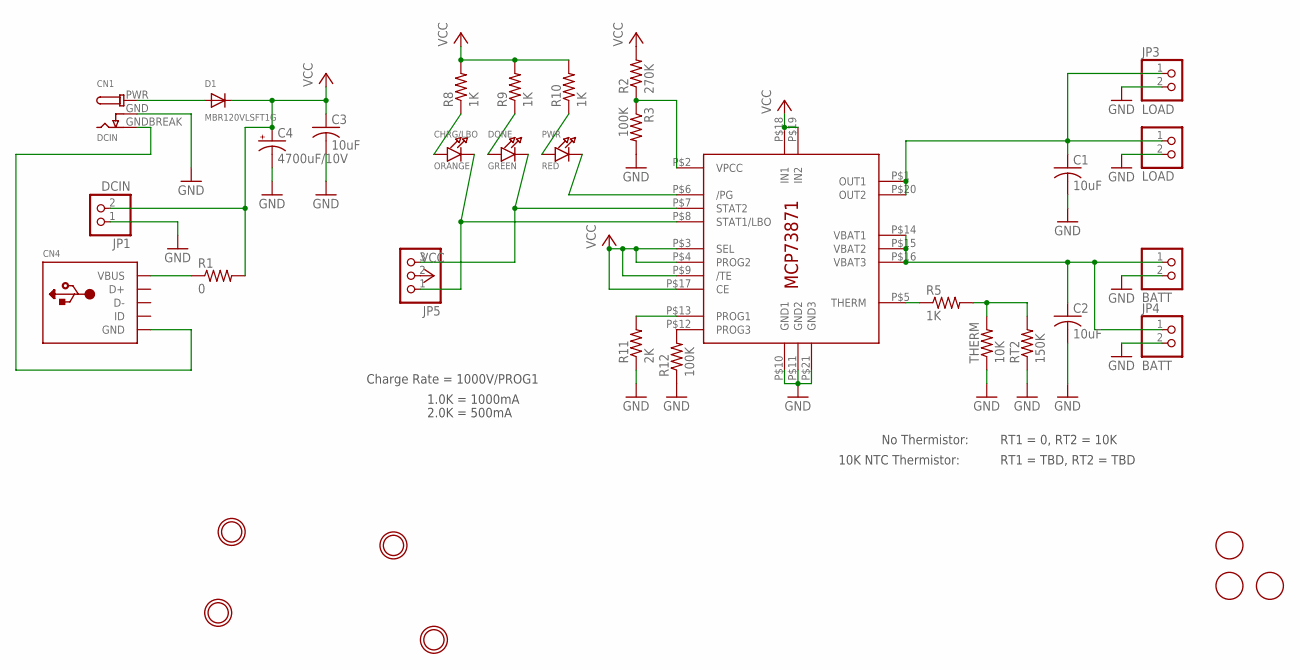
[picture p38: schematic Adafruit MCP73871 Solar Charger v4.sch]

Parts:
BATT: JST_2PIN-SMT-RA; JST-PH-2-SMT-RA
C1, C2, C3: 10uF; C0805K
C4: 4700uF/10V; E5-13
CHRG/LBO: ORANGE; CHIPLED_0805_NOOUTLINE
CN1: DCIN; DCJACK_2MM_SMT
CN4: USBMINIBLARGE; USB-MINIB_LARGER
D1: MBR120VLSFT1G; SOD-123
DONE: GREEN; CHIPLED_0805_NOOUTLINE
IC1: MCP73871; QFN20_4MM
JP1: DCIN; 1X02_OVAL
JP3: LOAD; 1X02_ROUND
JP4: BATT; 1X02_ROUND
JP5: PINHD-1X3CB; 1X03-CLEANBIG
LOAD: JST_2PIN-SMT-RA; JST-PH-2-SMT-RA
PWR: RED; CHIPLED_0805_NOOUTLINE
R1: 0; R0805
R2: 270K; R0805
R3, R12: 100K; R0805
R5: 1K; M0805
R8, R9, R10: 1K; R0805
R11: 2K; 0805-THM
RT2: 150K; M0805
THERM: 10K; 0805-THM
U$2, U$3, U$8: FIDUCIAL; FIDUCIAL_1MM
U$4, U$5, U$6, U$7: MOUNTINGHOLE2.5; MOUNTINGHOLE_2.5_PLATED

Connections:
BATT: BATT.1 (2), C2.1, IC1.P$14 (VBAT1), IC1.P$15 (VBAT2), IC1.P$16 (VBAT3), JP4.1
GND: BATT.2 (1), C1.2, C2.2, C3.2, C4.-, CN1.GND (GNDBREAK), IC1.P$10 (GND1), IC1.P$11 (GND2), IC1.P$21 (GND3), JP1.1, JP3.2, JP4.2, LOAD.2 (1), R3.2, R11.1, R12.1, RT2.1, THERM.1
unnamed: IC1.P$6 (/PG), PWR.C
unnamed: CN4.VBUS, R1.1
unnamed: CN1.GNDBREAK (GND), CN4.GND, CN4.GND1 (GND), CN4.GND2 (GND), CN4.GND3 (GND), CN4.GND4 (GND)
unnamed: DONE.C, IC1.P$7 (STAT2), JP5.3
unnamed: IC1.P$5 (THERM), R5.1
unnamed: IC1.P$2 (VPCC), R2.1, R3.1
unnamed: R5.2, RT2.2, THERM.2
unnamed: CN1.PWR, D1.A
unnamed: CHRG/LBO.C, IC1.P$8 (STAT1/LBO), JP5.1
unnamed: CHRG/LBO.A, R8.1
unnamed: DONE.A, R9.1
unnamed: PWR.A, R10.1
unnamed: IC1.P$12 (PROG3), R12.2
unnamed: IC1.P$13 (PROG1), R11.2
OUT: C1.1, IC1.P$1 (OUT1), IC1.P$20 (OUT2), JP3.1, LOAD.1 (2)
VCC: C3.1, C4.+, D1.C, IC1.P$3 (SEL), IC1.P$4 (PROG2), IC1.P$9 (/TE), IC1.P$17 (CE), IC1.P$18 (IN1), IC1.P$19 (IN2), JP1.2, JP5.2, R1.2, R2.2, R8.2, R9.2, R10.2

Notes on the sheet:
Charge Rate = 1000V/PROG1
1.0K = 1000mA
2.0K = 500mA
No Thermistor:
10K NTC Thermistor:
RT1 = 0, RT2 = 10K
RT1 = TBD, RT2 = TBD

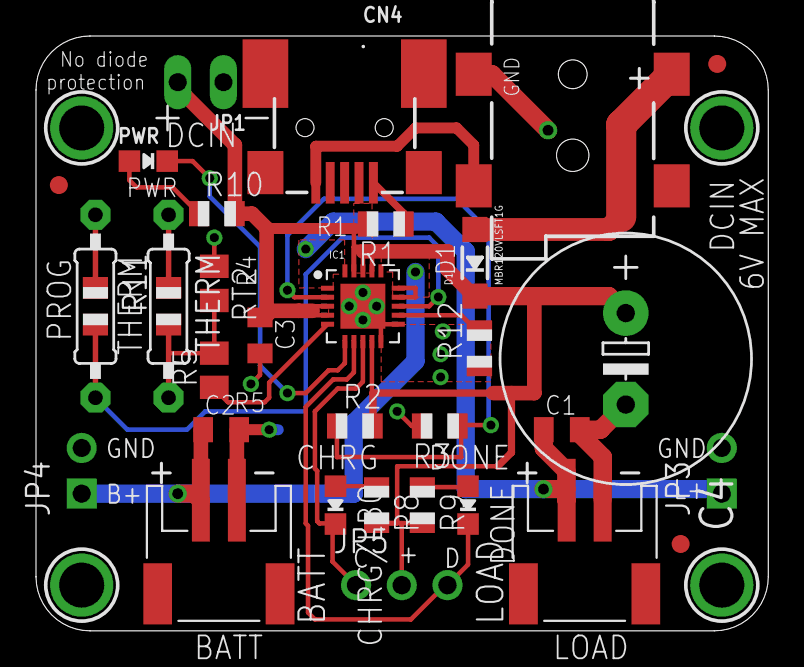
[picture p39: board Adafruit MCP73871 Solar Charger v4.brd from above]

Board: 2 copper layers, 40.7 x 33.0 mm, 36 parts (1 on the bottom side), 18 nets.

Other parts of the board:
U$1: ADAFRUIT_TEXT_20MM
