inventowiz/Hail-Met/schematics/reference_designs/Arduino-Mini-v5.brd

## EAGLE design schematics/reference_designs/Arduino-Mini-v5.brd (2014-10-09)

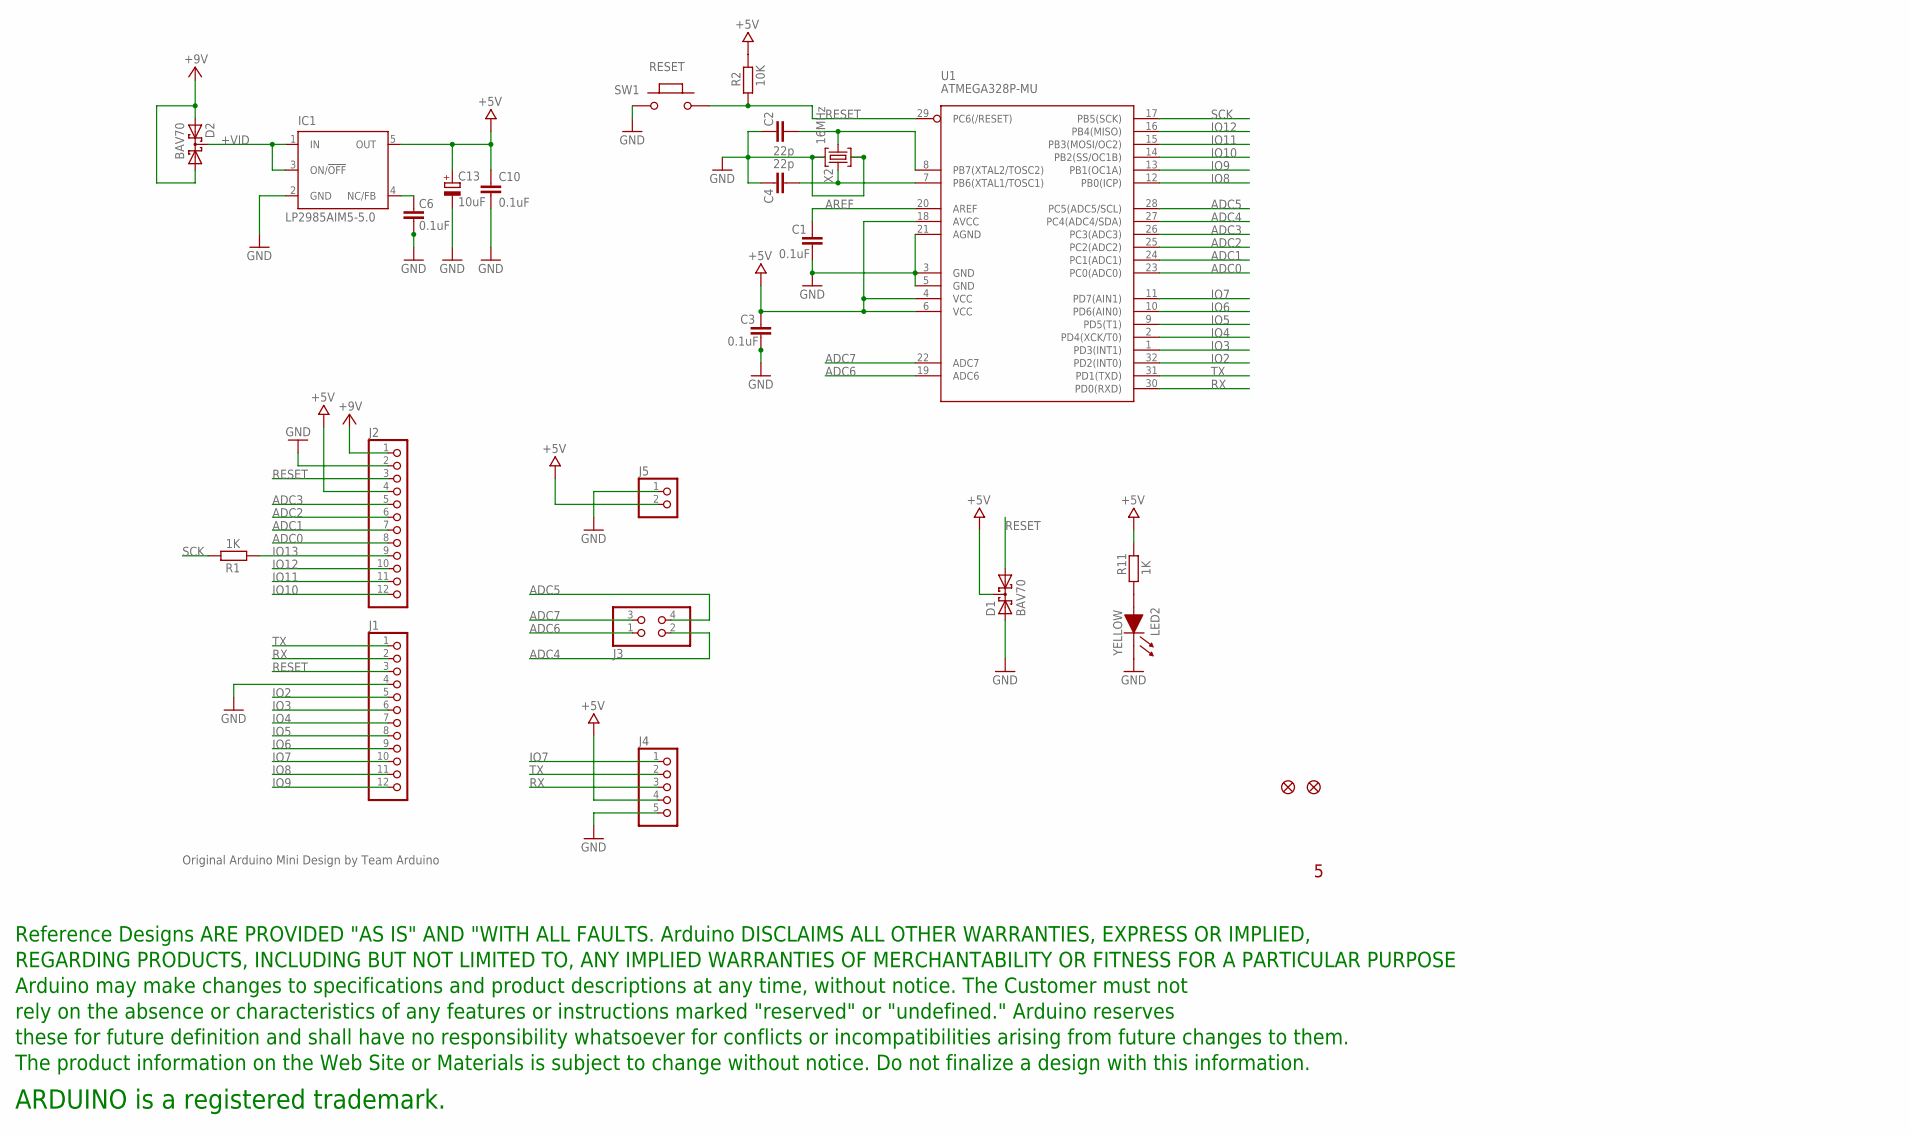
[picture p40: schematic Arduino-Mini-v5.sch]

Parts:
C1, C3, C6, C10: 0.1uF; C0603-ROUND
C2, C4: 22p; C0603-ROUND
C13: 10uF; SMC_B
D1, D2: BAV70; SOT23
IC1: LP2985AIM5-5.0; SOT23-DBV
J1, J2: PINHD-1X12; 1X12
J3: PINHD-2X2; 2X02
J4: PINHD-1X5; 1X5
J5: PINHD-1X2; 1X2
LED2: YELLOW; SMD_LED0805
R1, R11: 1K; R0603-ROUND
R2: 10K; R0603-ROUND
SW1: RESET; SMD_157SW
U1: ATMEGA328P-MU; MLF32-M1-A
U$2, U$4: FIDUCIAL1X2; FIDUCIAL-1X2
U$11: DISCLAIMER
X2: 16MHz; CRYSTAL-3.2-2.5

Connections:
+5V: C3.2, C10.1, C13.+, D1.3 (C), IC1.5 (OUT), J2.4, J4.4, J5.2, R2.2, R11.2, U1.4 (VCC), U1.6 (VCC), U1.18 (AVCC)
+VID: D2.3 (C), IC1.1 (IN), IC1.3 (ON/!OFF)
ADC0: J2.8, U1.23 (PC0(ADC0))
ADC1: J2.7, U1.24 (PC1(ADC1))
ADC2: J2.6, U1.25 (PC2(ADC2))
ADC3: J2.5, U1.26 (PC3(ADC3))
ADC4: J3.2, U1.27 (PC4(ADC4/SDA))
ADC5: J3.4, U1.28 (PC5(ADC5/SCL))
ADC6: J3.1, U1.19 (ADC6)
ADC7: J3.3, U1.22 (ADC7)
AREF: C1.2, U1.20 (AREF)
GND: C1.1, C2.2, C3.1, C4.2, C6.1, C10.2, C13.-, D1.1 (A1), IC1.2 (GND), J1.4, J2.2, J4.5, J5.1, LED2.1 (CA), SW1.1, U1.3 (GND), U1.5 (GND), U1.21 (AGND), X2.2 (GND), X2.4 (GND)
IO2: J1.5, U1.32 (PD2(INT0))
IO3: J1.6, U1.1 (PD3(INT1))
IO4: J1.7, U1.2 (PD4(XCK/T0))
IO5: J1.8, U1.9 (PD5(T1))
IO6: J1.9, U1.10 (PD6(AIN0))
IO7: J1.10, J4.1, U1.11 (PD7(AIN1))
IO8: J1.11, U1.12 (PB0(ICP))
IO9: J1.12, U1.13 (PB1(OC1A))
IO10: J2.12, U1.14 (PB2(SS/OC1B))
IO11: J2.11, U1.15 (PB3(MOSI/OC2))
IO12: J2.10, U1.16 (PB4(MISO))
IO13: J2.9, R1.1
unnamed: C4.1, U1.7 (PB6(XTAL1/TOSC1)), X2.1 (C1)
unnamed: C2.1, U1.8 (PB7(XTAL2/TOSC2)), X2.3 (C2)
unnamed: C6.2, IC1.4 (NC/FB)
unnamed: LED2.2 (AN), R11.1
RESET: D1.2 (A2), J1.3, J2.3, R2.1, SW1.2, U1.29 (PC6(/RESET))
RX: J1.2, J4.3, U1.30 (PD0(RXD))
SCK: R1.2, U1.17 (PB5(SCK))
TX: J1.1, J4.2, U1.31 (PD1(TXD))
VCC: D2.1 (A1), D2.2 (A2), J2.1

Notes on the sheet:
Original Arduino Mini Design by Team Arduino

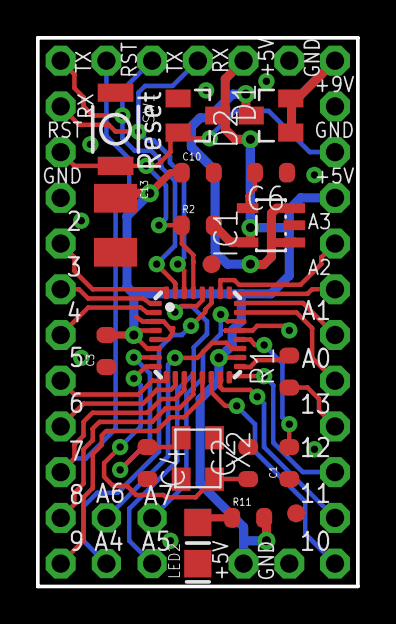
[picture p41: board Arduino-Mini-v5.brd from above]

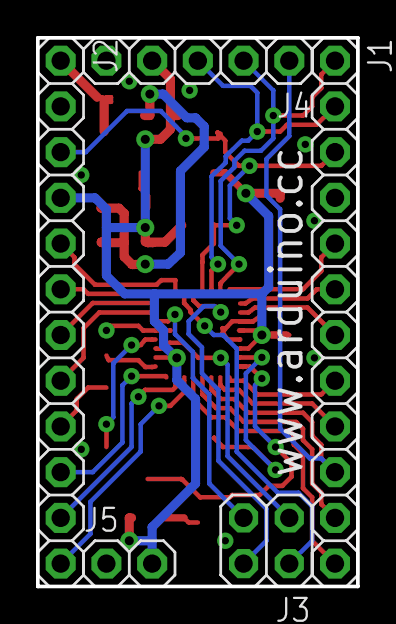
[picture p42: board Arduino-Mini-v5.brd from below]

Board: 2 copper layers, 17.8 x 30.5 mm, 25 parts (5 on the bottom side), 33 nets.
