inventowiz/Hail-Met/code/hailmet/HelmetIO.cpp

#include "HelmetIO.h"


// Bits that represent lights
// MSB
// 7 - Call Status
// 6 - Right Rear
// 5 - Right Middle
// 4 - Right Front
// 3 - Taillight
// 2 - Left Rear
// 1 - Left Middle
// 0 - Left Front

char HelmetIO::generateLedStates() {
  char res = 0;
  
  if (taillight && !taillightActive) {
    res |= 0x8;
    taillightActive = true;
  } else {
    res &= ~(0x8);
    taillightActive = false;
  }
  
  if (leftSignal && leftSignalsActive == 0) {
    res |= 0x7;
    leftSignalsActive = 0x7;
  } else {
    res &= ~(0x7);
    leftSignalsActive = 0x0;
  }
  
  if (rightSignal && rightSignalsActive == 0) {
    res |= 0x70;
    rightSignalsActive = 0x7;
  } else {
    res &= ~(0x70);
    rightSignalsActive = 0x0;
  }
  
  if (callStatus != NO_CALL || lowBattery) {
    if (callStatus == INCOMING_CALL) {
      if (!indicatorActive) {
        res |= 0x80;
        indicatorActive = true;
      } else {
        res &= ~(0x80);
        indicatorActive = false;
      }
    } else if (callStatus == ACTIVE_CALL) {
      res |= 0x80;
      indicatorActive = true;
    } else if (lowBattery) {
      if (lowBatteryDelay == 0) {
        res |= 0x80;
        indicatorActive = true;
      } else {
        res &= ~(0x80);
        indicatorActive = false;
      }
      
      if (lowBatteryDelay >= 3) {
        lowBatteryDelay = 0;
      } else {
        lowBatteryDelay++;
      }
    }
  } else {
    res &= ~(0x80);
    indicatorActive = true;
  }
  
  return res;
}

void HelmetIO::init(LedDriver &ledDriver, int headlightPin) {
  this->ledDriver = &ledDriver;
  this->headlightPin = headlightPin;
  
  leftSignalsActive = 0;
  rightSignalsActive = 0;
  indicatorActive = false;
  taillightActive = false;
  headlightBrightness = 255;
  lowBatteryDelay = 0;
  callStatus = NO_CALL;
  
  this->ledDriver->write(0);
  disableHeadlight();
}

// Called within loop (or timer interrupt)
void HelmetIO::updateLights() {
  ledDriver->write(generateLedStates());
  
  if (headlight) {
    updateHeadlightBrightness();
  }
}

void HelmetIO::enableHeadlight() {
  headlight = true;
  updateHeadlightBrightness();
}

void HelmetIO::disableHeadlight() {
  headlight = false;
  digitalWrite(headlightPin, LOW);
}

void HelmetIO::setHeadlightBrightness(int brightness){
  headlightBrightness = brightness;
}

void HelmetIO::updateHeadlightBrightness() {
  analogWrite(headlightPin, headlightBrightness);
}

bool HelmetIO::getHeadlight() {
  return headlight;
}

void HelmetIO::enableTaillight() {
  taillight = true;
}

void HelmetIO::disableTaillight() {
  taillight = false;
}

void HelmetIO::enableLeftTurnSignal() {
  leftSignal = true;
}

void HelmetIO::disableLeftTurnSignal() {
  leftSignalsActive = 0;
  leftSignal = false;
}

bool HelmetIO::getLeftTurnSignal() {
  return leftSignal;
}

void HelmetIO::enableRightTurnSignal() {
  rightSignal = true;
}

void HelmetIO::disableRightTurnSignal() {
  rightSignalsActive = 0;
  rightSignal = false;
}

bool HelmetIO::getRightTurnSignal() {
  return rightSignal;
}

void HelmetIO::setCallStatus(int status) {
  callStatus = status;
  if (callStatus == NO_CALL) {
    indicatorActive = false;
  }
}

void HelmetIO::enableLowBattery() {
  lowBattery = true;
}

void HelmetIO::disableLowBattery() {
  lowBattery = false;
}
