inventowiz/Hail-Met/(commit log)

2014-10-05 wrote initial LED driver library
2014-10-05 added LED driver spec sheet
2014-10-09 Started PCB schematic
    [Arduino-Mini-v5.brd, Arduino-Mini-v5.sch, arduino_Uno_Rev3-02-TH.brd, arduino_Uno_Rev3-02-TH.sch, hail-met-v0.sch]
2014-10-10 updated schematic, added datasheets
    [Adafruit MCP73871 Solar Charger v4.brd, Adafruit MCP73871 Solar Charger v4.sch, MCP73871_Solar.brd, MCP73871_Solar.sch, hail-met-v0.sch]
2014-10-10 cleaned up EAGLE temp files
    [hail-met-v0.sch]
2014-10-14 Added Bluetooth libraries and Arduino sketch
2014-10-15 Changed LED Driver code to work on HW SPI instead of bit-bang
2014-10-15 updated schematic
    [hail-met-v0.sch]
2014-10-17 worked on schematic
    [hail-met-v0.brd, hail-met-v0.sch]
2014-10-23 Added bluetooth pairing button
2014-10-23 updated schematic with pins (CPU pins not verified)
    [hail-met-v0.brd, hail-met-v0.sch]
2014-10-24 modified schematic slightly and began board layout.
    [hail-met-v0.brd, hail-met-v0.sch]
2014-10-24 updated schematic/board and datasheets
    [hail-met-v0.brd, hail-met-v0.sch]
2014-10-26 whoops, fixed the mistake hopefully
    [headlamp_enclosure_cubify.stl, leftEarBottom.stl, leftEarBottom_cubify.stl, leftEarTop.stl, leftEarTop_cubify.stl, rightEarBottom.stl, rightEarTop.stl]
2014-10-27 finished initial schematic and routing, updated software pin assignment
    [hail-met-v0.brd, hail-met-v0.sch]
2014-10-27 added some power planes
    [hail-met-v0.brd, hail-met-v0.sch]
2014-10-27 routing pcb
    [hail-met-v0.brd, hail-met-v0.sch]
2014-10-28 added to layout
    [hail-met-v0.brd, hail-met-v0.sch]
2014-10-28 updated routing
    [hail-met-v0.brd]
2014-10-29 worked on routing
    [hail-met-v0.brd]
2014-10-30 finished initial PCB routing/layout
    [hail-met-v0.brd]
2014-10-30 Added more 3d designs
    [leftEarBottom_cubify.stl, rightEarBottom_cubify.stl, rightEarTop.stl, rightEarTop_cubify.stl]
2014-10-30 added headlight code (NEED TEST) and updated pcb
    [hail-met-v0.brd, hail-met-v0.sch]
2014-10-30 Fixed an error with compilation, but it works now
    [HelmetIO.cpp, HelmetIO.h]
2014-10-31 added pull-down for transistor
    [hail-met-v0.brd, hail-met-v0.sch]
2014-10-31 added some decoupling caps to the board, prep for ben
    [hail-met-v0.brd, hail-met-v0.sch]
2014-10-31 finalized board design, added new npn datasheet
    [hail-met-v0.brd, hail-met-v0.sch]
2014-11-01 ordered pcb
    [hail-met-v0.brd, hail-met-v0.sch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]
2014-11-03 added in functionality to accept or decline calls over bluetooth with a button
2014-11-04 Added more 3d ish
    [helmetBrim.stl, helmetBrimLid.stl, helmetBrimLid_cubify.stl, helmetBrim_cubify.stl]
2014-11-04 added stencils, BOM, and finalized PCB
    [hail-met-v0.brd, hail-met-v0_Bill of materials.xlsx, hail-met_hail-met-v0_0_standard.dxf]
2014-11-04 changed some cube files, modified the helmet brim
    [helmetBrimLid_cubify.stl, helmetBrimLid_cubify_v.stl, helmetBrim_cubify.stl]
2014-11-13 Refactored button code, fixed bugs, cleaned up main function, and added voice command capability
    [Button.cpp, Button.h, HelmetIO.cpp, HelmetIO.h, RN52.cpp, RN52.h, hailmet.ino]
2014-11-17 +call indicator leds, fixed rn52 state reading/polling
    [HelmetIO.cpp, HelmetIO.h, hailmet.ino]
2014-11-17 Added more 3d models woo
    [chinStrapModule.stl, chinStrapModule_cubify.stl, helmetBrimLeft.stl, helmetBrimLeft_cubify.stl, helmetBrimRight.stl, helmetBrimRight_cubify.stl, helmetBrim_cubify.stl, turnSignalsLeft_cubify.stl]
2014-11-17 +Programming mode, no need to disconnect RX/TX lines to reprogram arduino. Simply press and hold discovery button
2014-11-17 Changed pins to reflect PCB
2014-11-20 Started v1 of board
    [hail-met-v1.brd, hail-met-v1.sch]
2014-11-21 updated schematics (v0, v1) and datasheets
    [hail-met-v0.sch, hail-met-v1.brd, hail-met-v1.sch, thermistor_resistor_calculator.xlsx]
2014-11-22 updated schematic with charge termination current resistor
    [hail-met-v0.brd, hail-met-v0.sch, hail-met-v1.sch]
2014-11-24 Added chinstrap module version with spots for screws
    [chinStrapModulev2.stl, chinStrapModulev2_cubify.stl]
2014-11-24 updated and routed v1 board
    [hail-met-v1.brd]
2014-11-24 added updated oscillator library
    [hail-met-v1.brd]
2014-11-24 Added front led signals
2014-11-24 Added solar panel housings
    [solarHOusingV1.stl, solarHOusingV1_cubify.stl, solarHOusingV1_cubify_v.stl]
2014-11-24 updated board v1
    [hail-met-v0.brd, hail-met-v0.sch, hail-met-v1.brd, hail-met-v1.sch]
2014-11-25 finished all 3d designs I think
    [pcbEnclosure.stl, pcbEnclosureBatterySlot.stl, pcbEnclosureBatterySlot_cubify.stl, pcbEnclosure_cubify.stl, tailLight.stl, tailLight_cubify.stl, tailLight_cubify_v.stl, turnSignalsFront.stl]
2014-11-27 modified board with audio amp values
    [hail-met-v0.brd, hail-met-v0.sch, hail-met-v1.brd, hail-met-v1.sch]
2014-12-01 updated schematic with new LED driver values
    [hail-met-v0.brd, hail-met-v0.sch]
2014-12-02 Added low battery indicator on call led
2014-12-03 Added final 3d parts
    [lightSensorEnclosure.stl, lightSensorEnclosure_cubify.stl, pcbEnclosureBatterySlot.stl, pcbEnclosureBatterySlot_cubify.stl, powerSwitch.stl, powerSwitch_cubify.stl, solarHousingGroup.stl, solarHousingGroup_cubify.stl]
2014-12-03 Changed light sensor pin
