inventowiz/Hail-Met/(notices)

Notices in the files:
schematics/hail-met-v1/hail-met-v1.brd:
(C) 2014
parts and their libraries:
SparkFun-Passives: Licensing: Creative Commons ShareAlike 4.0 International - https://creativecommons.org/licenses/by-sa/4.0
SparkFun-Capacitors: Licensing: CC v3.0 Share-Alike You are welcome to use this library for commercial purposes.
